GHF/gyroking/readme.txt

gyroking - firmware for the Gyro King 3lb battle bot
========
Xo Wang (http://www.geekshavefeelings.com)
Aaron Fan (http://aaronbot3000.blogspot.com)

About
-----
:D
