GHF/gyroking/3d_model/robot.sldasm

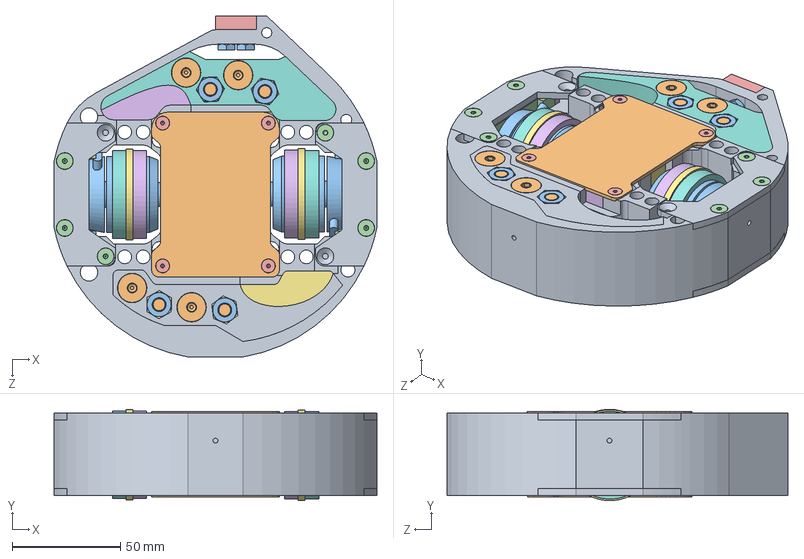
[picture p2: CAD file, 2013-03-10]
3d_model/robot.sldasm
149.2 x 42.2 x 157.7 mm
shell_xo
battery
motor x 2
motor_mount x 2
m3-8 x 8
hub x 2
tire_timing_belt x 2
hub_aluminum x 2
motor_lock x 4
cover x 2
6-32_nut x 4
damper-1_5-1_65 x 2
damper-2_70-1_5 x 2
damper-2-1_25 x 2
damper-0_375-1_25 x 2
damper-0_375-1 x 2
damper-0_34-1 x 2
damper-0_34-1_25 x 2
tooth
front_filler x 2
back_filler x 2
front_filler_wires
back_filler_wires
1-4_28_nut x 16
circuits
