GHF/gyroking/3d_model/motor_assm.sldasm

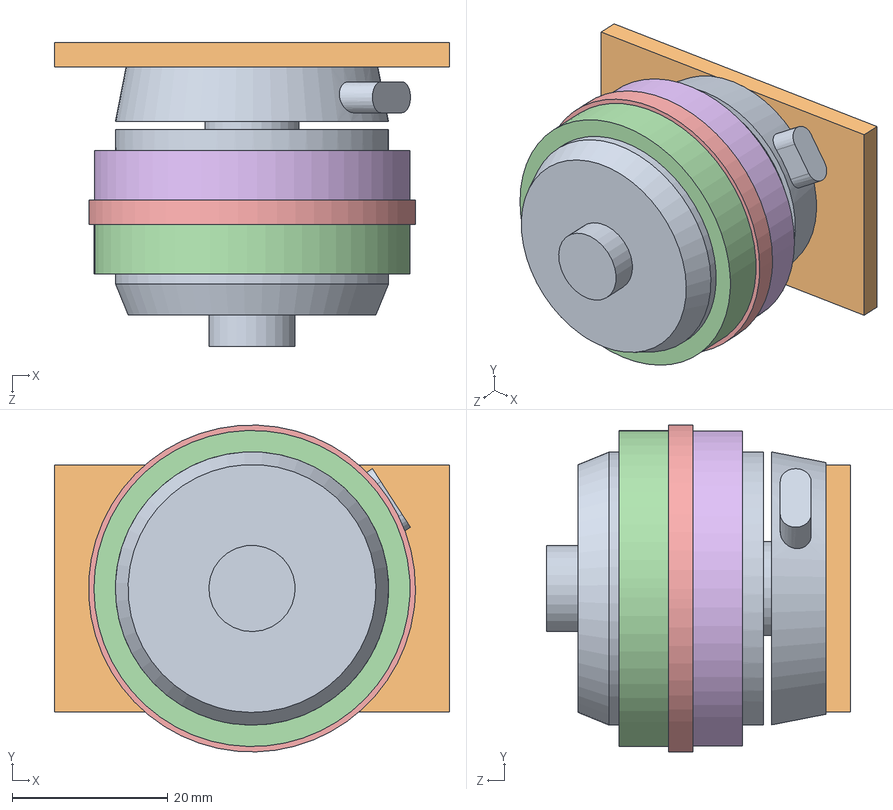
[picture p3: CAD file, 2013-03-10]
3d_model/motor_assm.sldasm
50.8 x 42.0 x 39.1 mm
motor
motor_mount
m3-8 x 4
hub
tire_timing_belt
hub_aluminum
