GHF/gyroking/3d_model/damper-2-1_25.sldprt

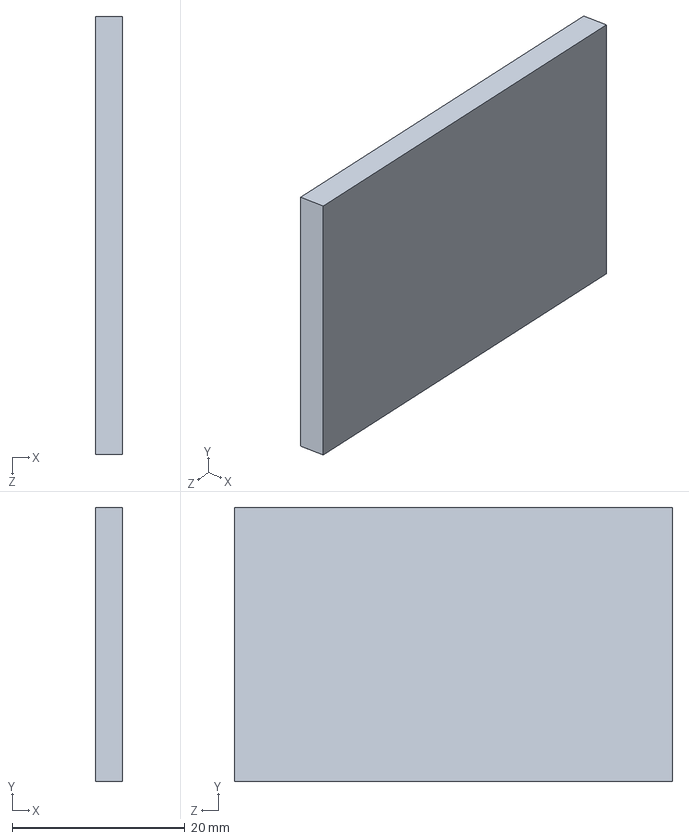
[picture p4: CAD file, 2013-03-10]
3d_model/damper-2-1_25.sldprt
3.17 x 31.8 x 50.8 mm
