GHF/gyroking/3d_model/damper-0_34-1_125.sldprt

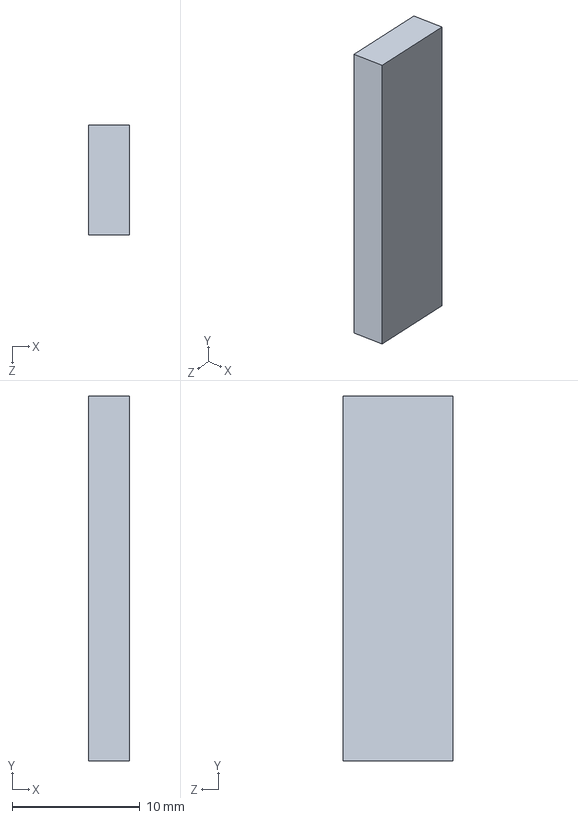
[picture p5: CAD file, 2013-03-10]
3d_model/damper-0_34-1_125.sldprt
3.17 x 28.6 x 8.64 mm
