GHF/gyroking/3d_model/damper-0_34-1.sldprt

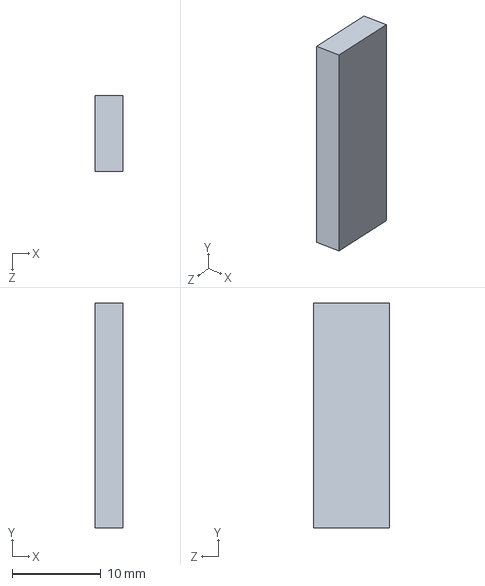
[picture p6: CAD file, 2013-03-10]
3d_model/damper-0_34-1.sldprt
3.17 x 25.4 x 8.64 mm
