GHF/gyroking/3d_model/damper-2_95-1_65.sldprt

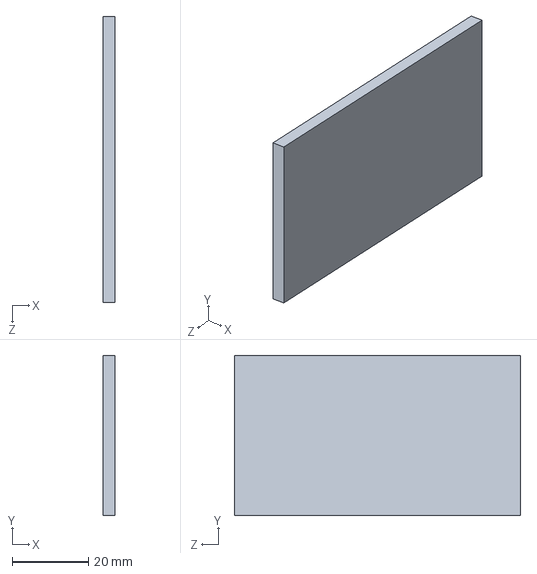
[picture p7: CAD file, 2013-03-10]
3d_model/damper-2_95-1_65.sldprt
3.17 x 41.9 x 74.9 mm
