GHF/gyroking/3d_model/cover.sldprt

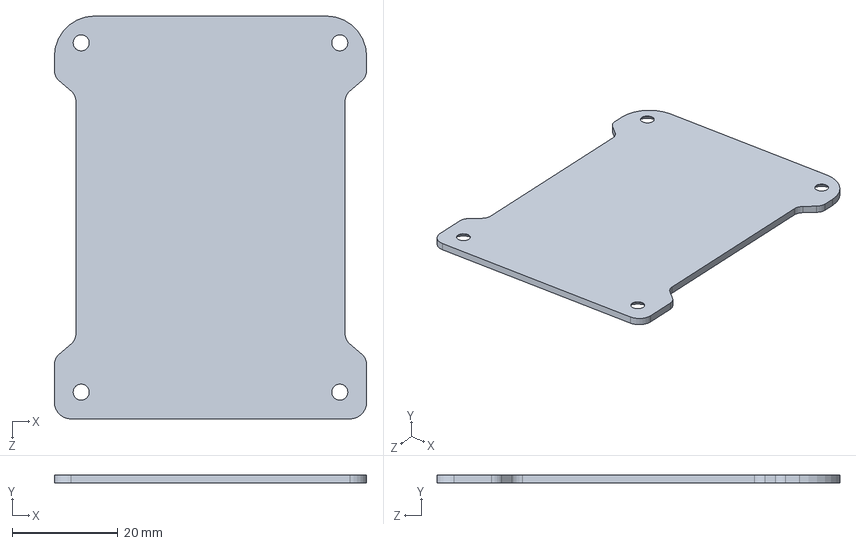
[picture p8: CAD file, 2013-03-10]
3d_model/cover.sldprt
59.1 x 1.59 x 76.2 mm
