GHF/gyroking/3d_model/back_filler_wires.sldprt

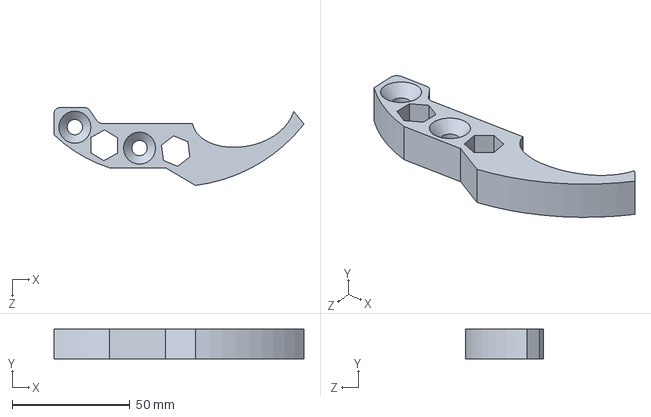
[picture p9: CAD file, 2013-03-10]
3d_model/back_filler_wires.sldprt
106.2 x 12.7 x 33.1 mm
