GHF/gyroking/3d_model/1_4-28_1_5.sldprt

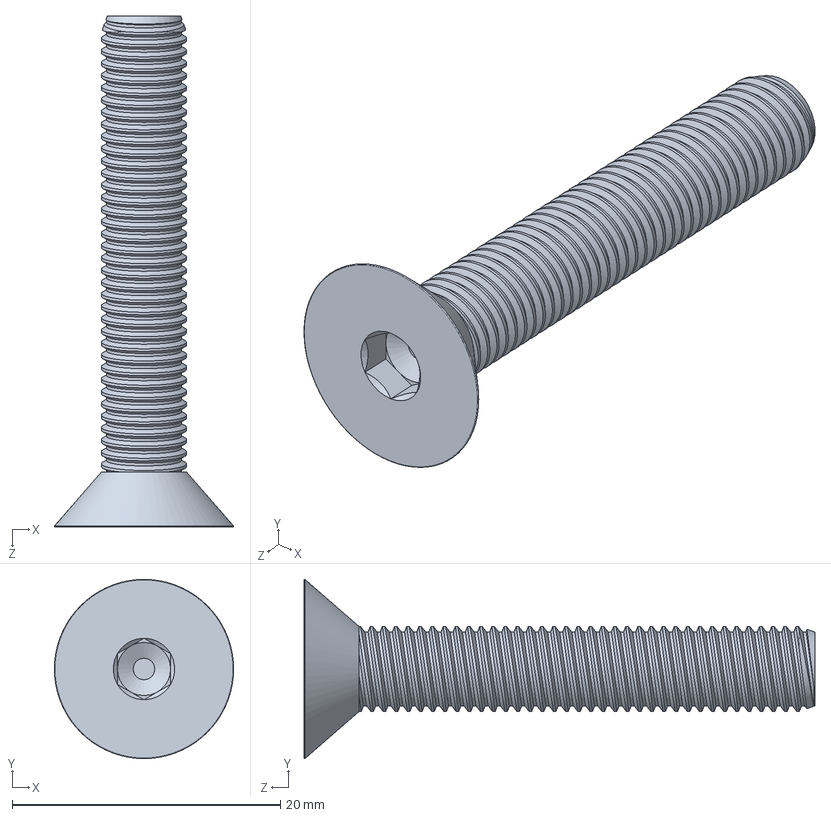
[picture p10: CAD file, 2013-03-10]
3d_model/1_4-28_1_5.sldprt
13.4 x 13.4 x 38.1 mm
