GHF/gyroking/3d_model/shell_waterjet.sldprt

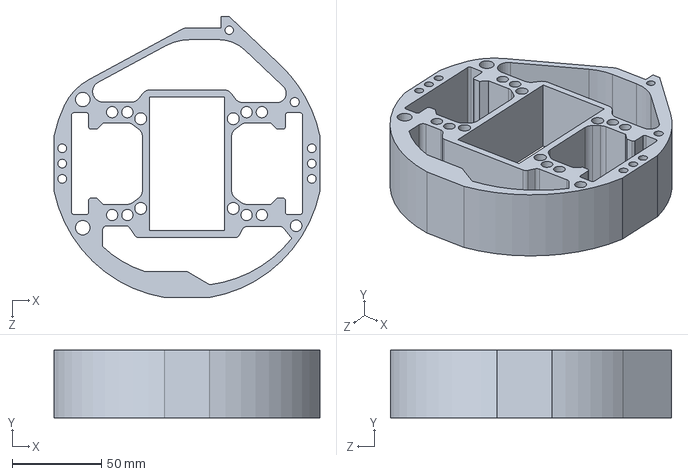
[picture p11: CAD file, 2013-03-10]
3d_model/shell_waterjet.sldprt
149.2 x 38.1 x 157.7 mm
