GHF/gyroking/3d_model/tire.sldprt

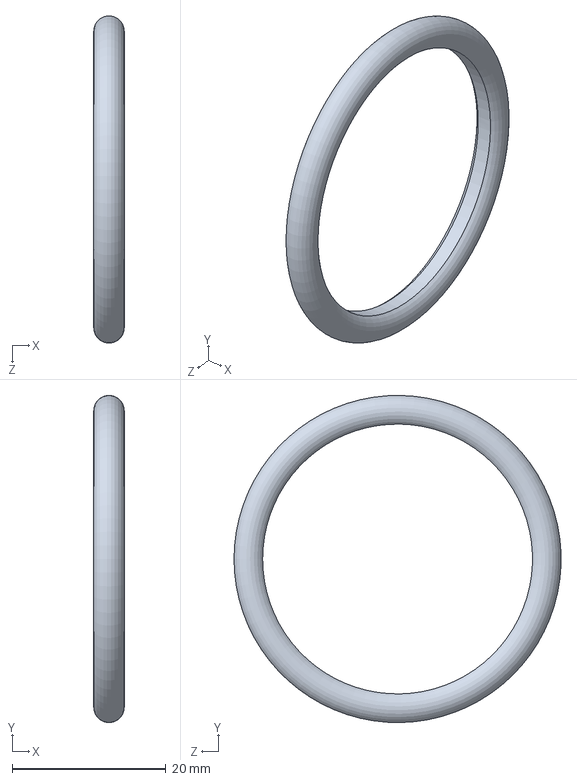
[picture p13: CAD file, 2013-03-10]
3d_model/tire.sldprt
3.99 x 42.6 x 42.6 mm
