GHF/gyroking/3d_model/damper-0_34-1_25.sldprt

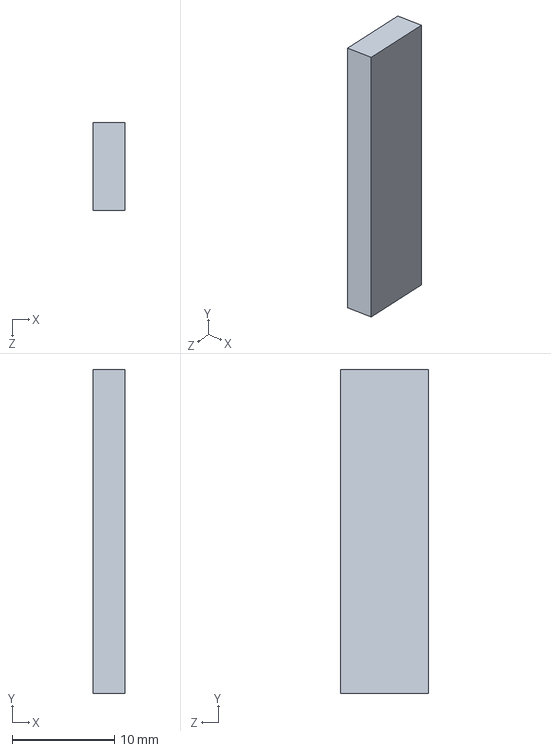
[picture p14: CAD file, 2013-03-10]
3d_model/damper-0_34-1_25.sldprt
3.17 x 31.8 x 8.64 mm
