GHF/gyroking/3d_model/tire_timing_belt.sldprt

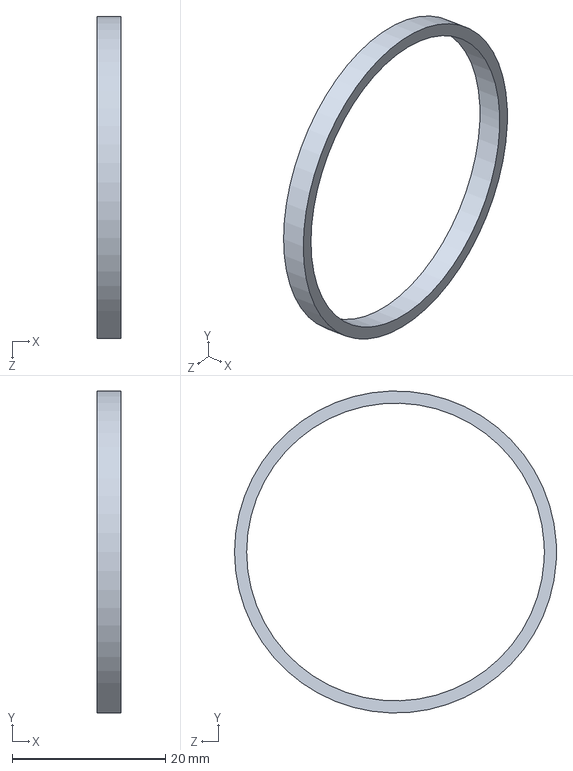
[picture p15: CAD file, 2013-03-10]
3d_model/tire_timing_belt.sldprt
3.17 x 42.0 x 42.0 mm
