GHF/gyroking/3d_model/circuits.sldprt

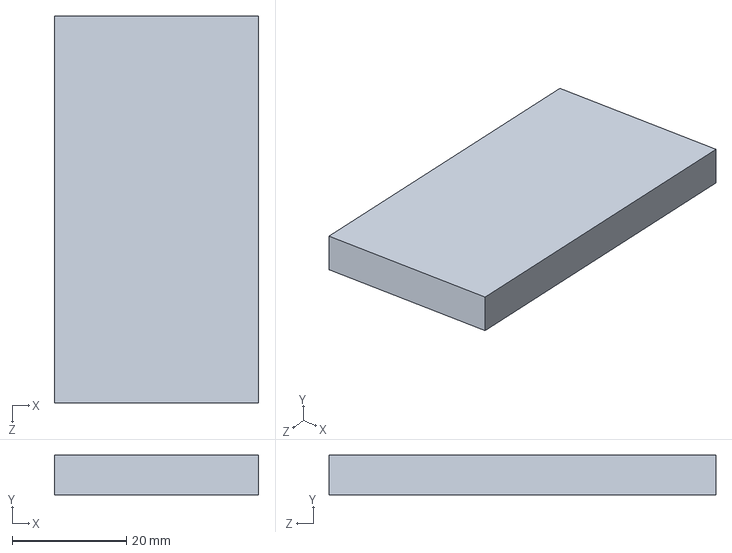
[picture p16: CAD file, 2013-03-10]
3d_model/circuits.sldprt
35.8 x 7.00 x 67.8 mm
