GHF/gyroking/3d_model/motor_mount.sldprt

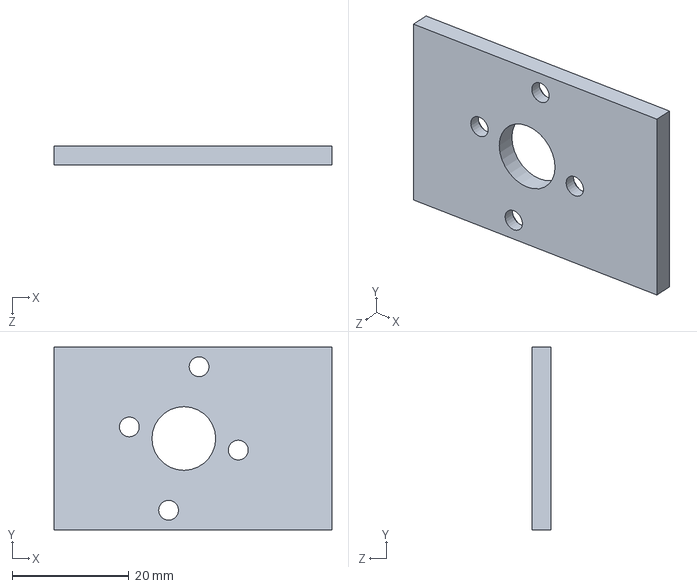
[picture p17: CAD file, 2013-03-10]
3d_model/motor_mount.sldprt
47.7 x 31.3 x 3.17 mm
