GHF/gyroking/3d_model/tooth.sldprt

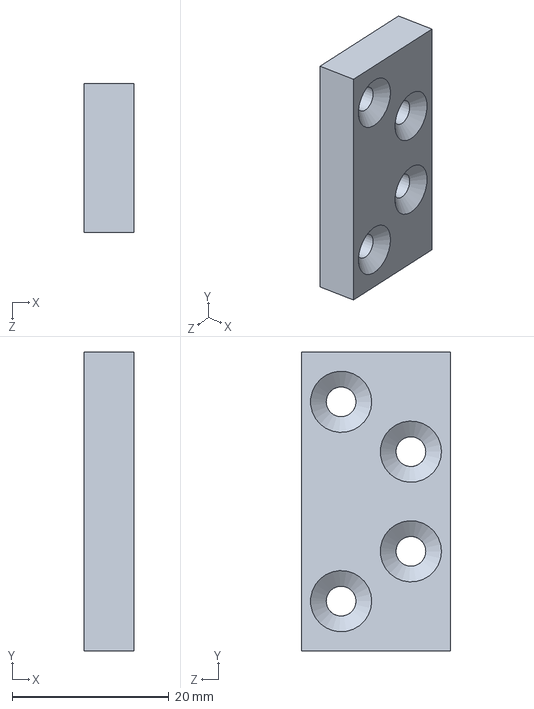
[picture p18: CAD file, 2013-03-10]
3d_model/tooth.sldprt
6.35 x 38.1 x 19.1 mm
