GHF/gyroking/3d_model/battery_350mah.sldprt

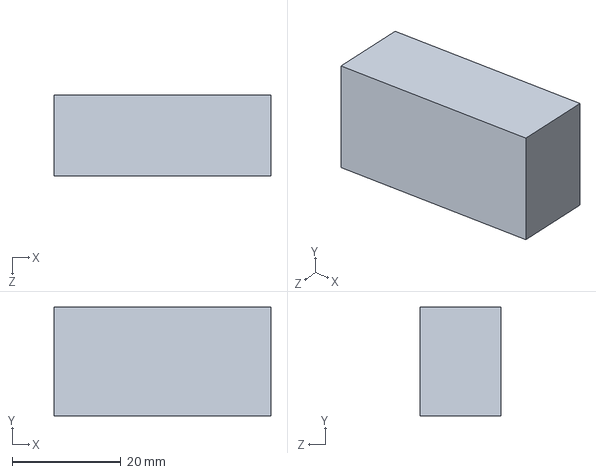
[picture p19: CAD file, 2013-03-10]
3d_model/battery_350mah.sldprt
40.0 x 20.0 x 15.0 mm
