GHF/gyroking/3d_model/4-40_3-8.sldprt

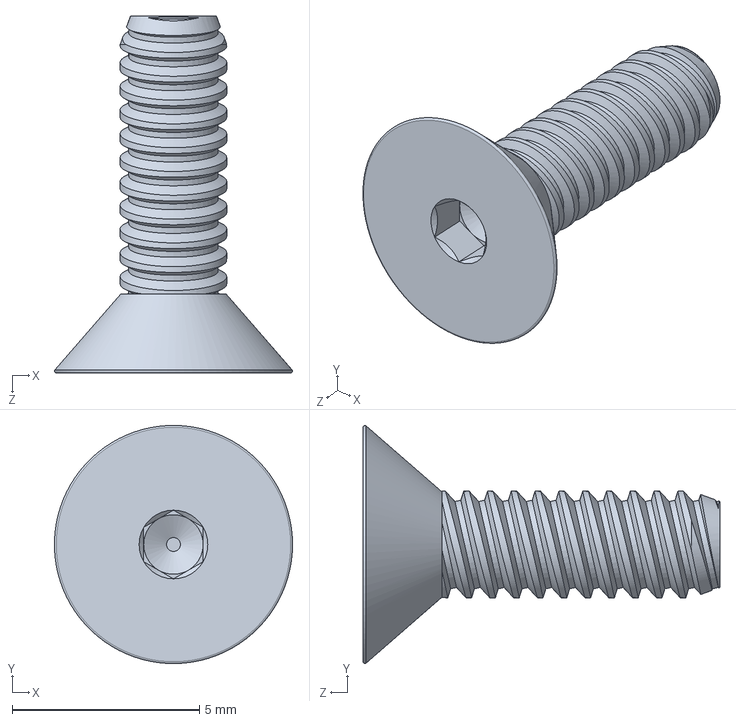
[picture p20: CAD file, 2013-03-10]
3d_model/4-40_3-8.sldprt
6.35 x 6.35 x 9.53 mm
