GHF/gyroking/3d_model/hub.sldprt

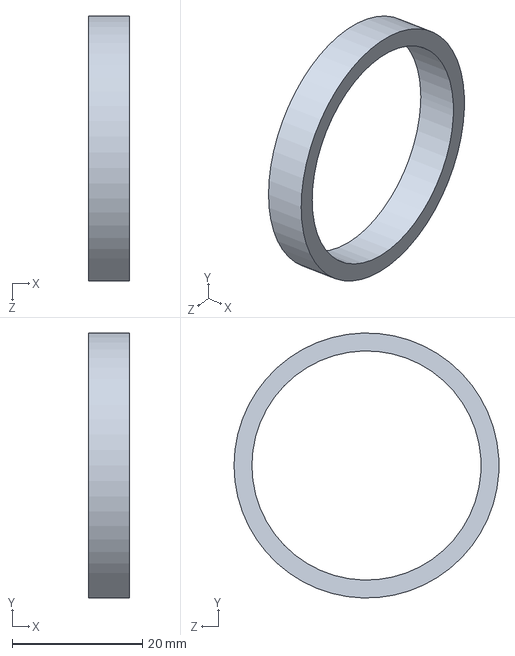
[picture p21: CAD file, 2013-03-10]
3d_model/hub.sldprt
6.35 x 40.6 x 40.7 mm
