GHF/gyroking/3d_model/battery_500mah.sldprt

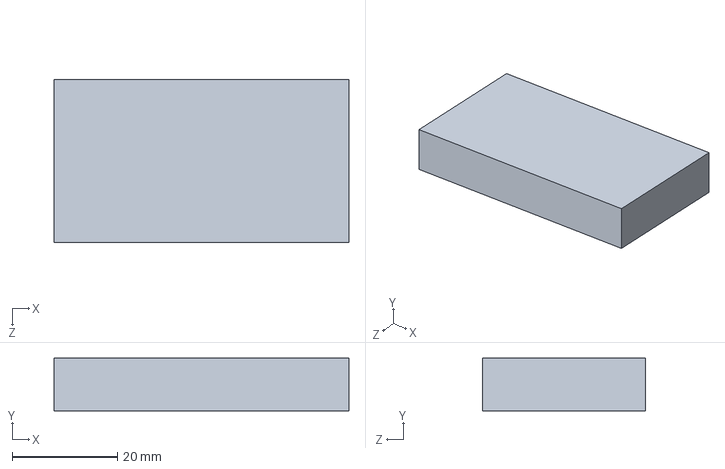
[picture p23: CAD file, 2013-03-10]
3d_model/battery_500mah.sldprt
56.0 x 10.0 x 31.0 mm
