GHF/gyroking/3d_model/battery.sldprt

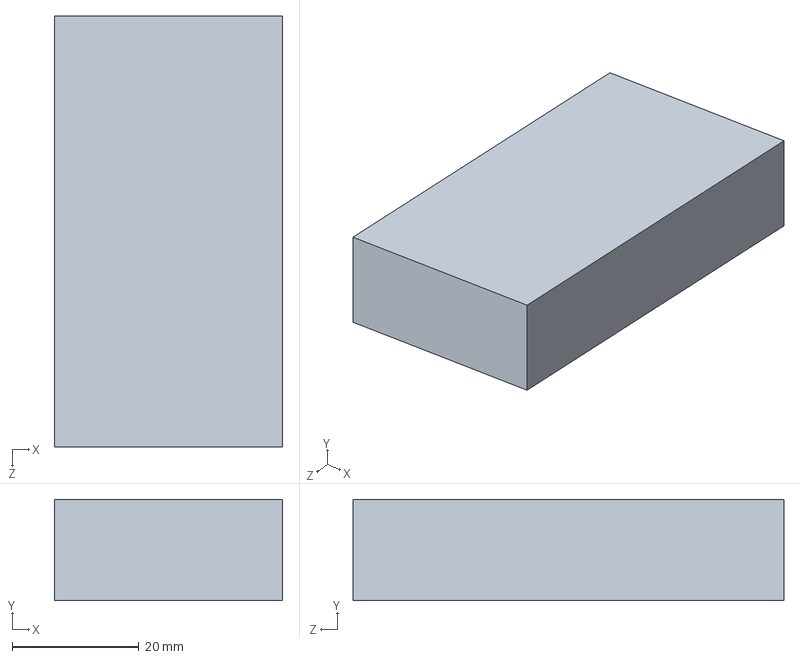
[picture p24: CAD file, 2013-03-10]
3d_model/battery.sldprt
36.0 x 16.0 x 68.0 mm
