GHF/gyroking/3d_model/4-40_1-2.sldprt

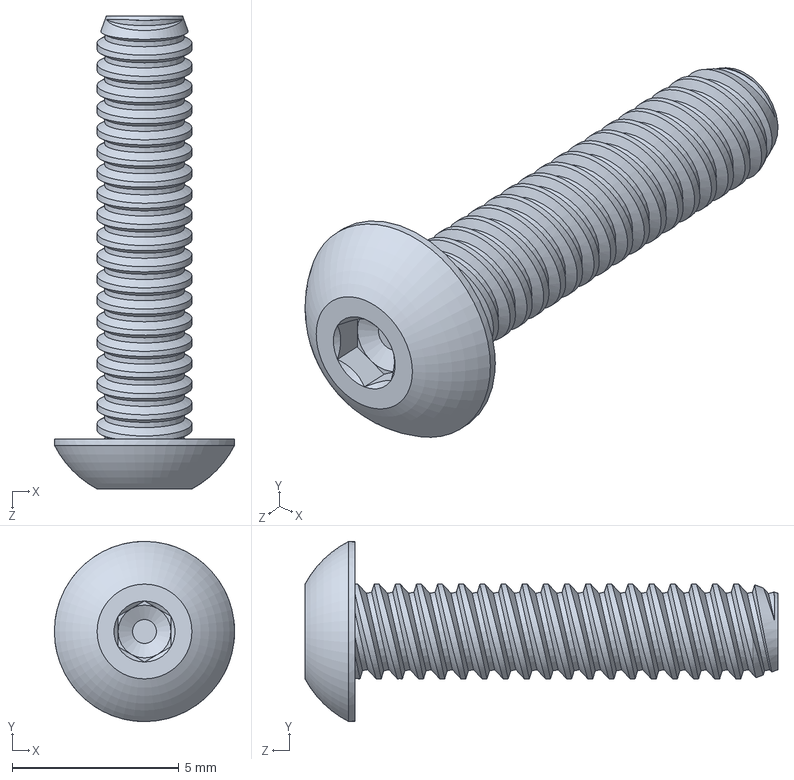
[picture p25: CAD file, 2013-03-10]
3d_model/4-40_1-2.sldprt
5.41 x 5.41 x 14.2 mm
