GHF/gyroking/3d_model/hub_aluminum.sldprt

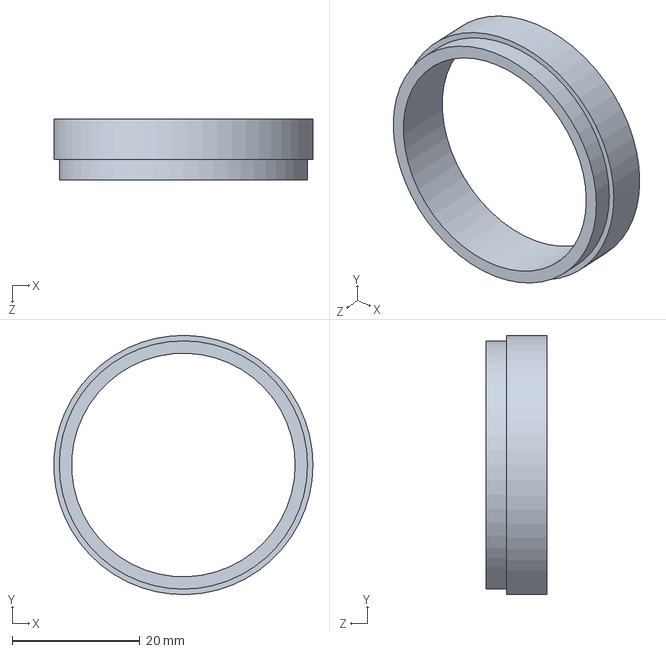
[picture p26: CAD file, 2013-03-10]
3d_model/hub_aluminum.sldprt
40.6 x 40.6 x 9.53 mm
