GHF/gyroking/3d_model/motor_lock.sldprt

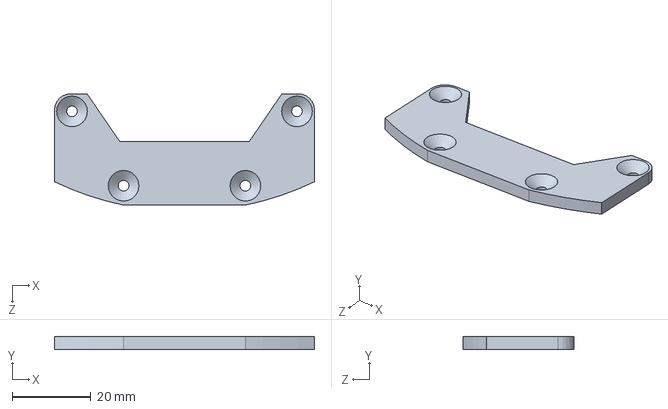
[picture p27: CAD file, 2013-03-10]
3d_model/motor_lock.sldprt
66.0 x 3.17 x 28.3 mm
