GHF/gyroking/3d_model/damper-2_70-1_5.sldprt

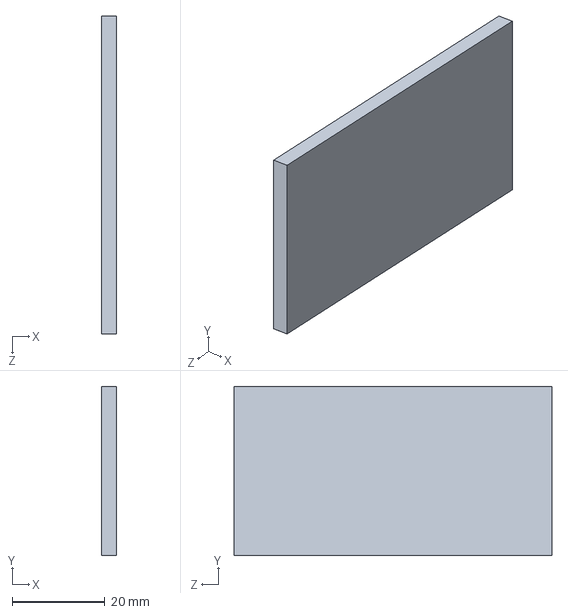
[picture p28: CAD file, 2013-03-10]
3d_model/damper-2_70-1_5.sldprt
3.17 x 36.5 x 68.6 mm
