GHF/gyroking/3d_model/front_filler.sldprt

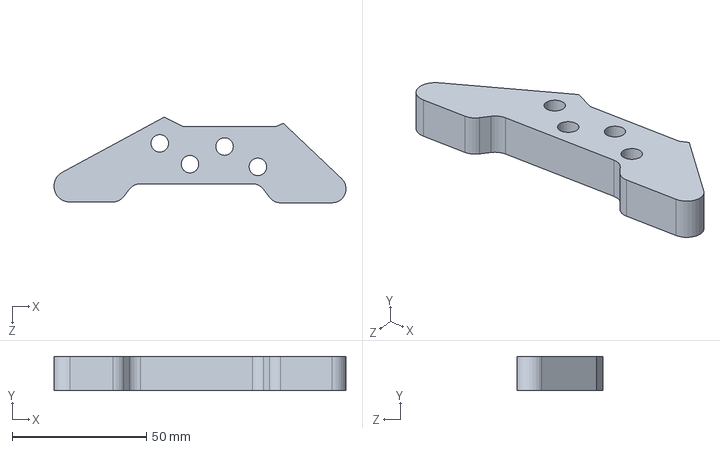
[picture p29: CAD file, 2013-03-10]
3d_model/front_filler.sldprt
108.6 x 12.7 x 31.9 mm
