GHF/gyroking/3d_model/damper-0_375-1_125.sldprt

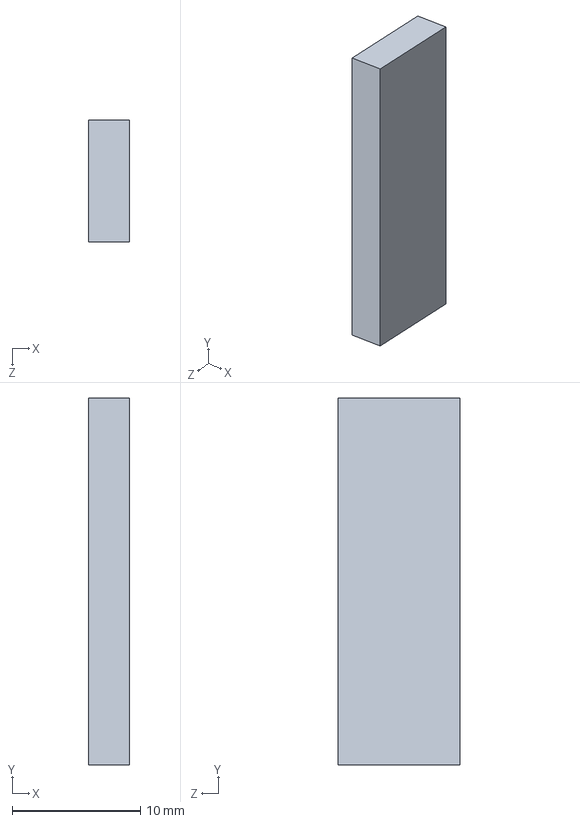
[picture p30: CAD file, 2013-03-10]
3d_model/damper-0_375-1_125.sldprt
3.17 x 28.6 x 9.53 mm
