GHF/gyroking/3d_model/motor.sldprt

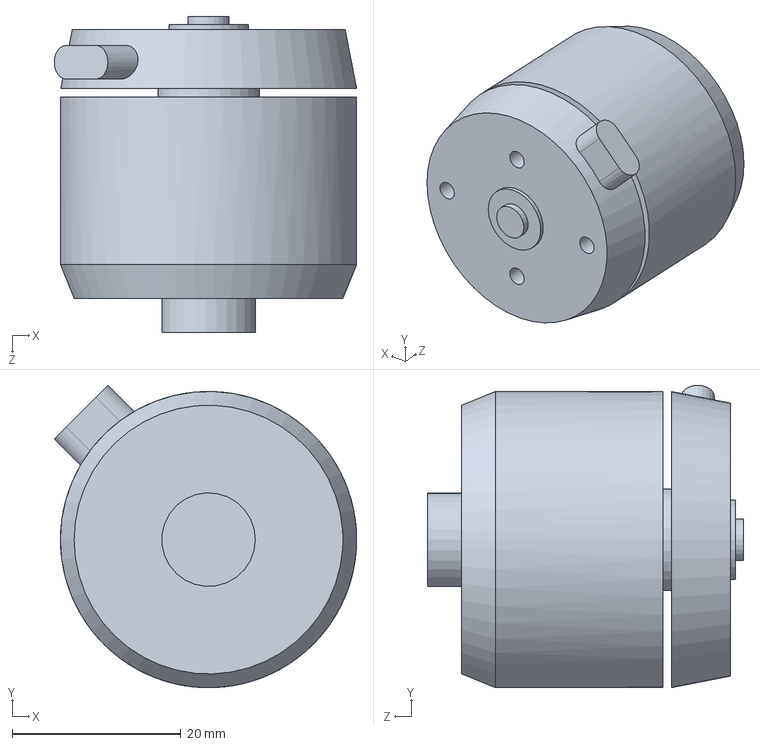
[picture p31: CAD file, 2013-03-10]
3d_model/motor.sldprt
35.9 x 35.9 x 37.5 mm
