GHF/gyroking/3d_model/back_filler.sldprt

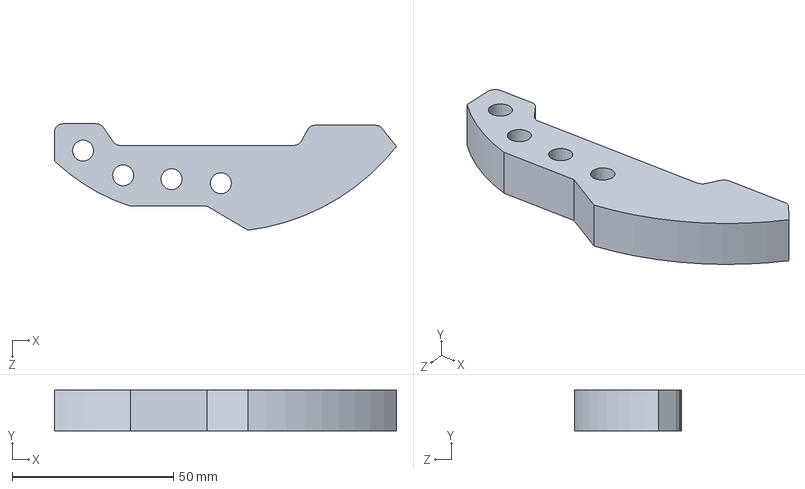
[picture p33: CAD file, 2013-03-10]
3d_model/back_filler.sldprt
106.2 x 12.7 x 33.1 mm
