GHF/gyroking/3d_model/damper-1_5-1_65.sldprt

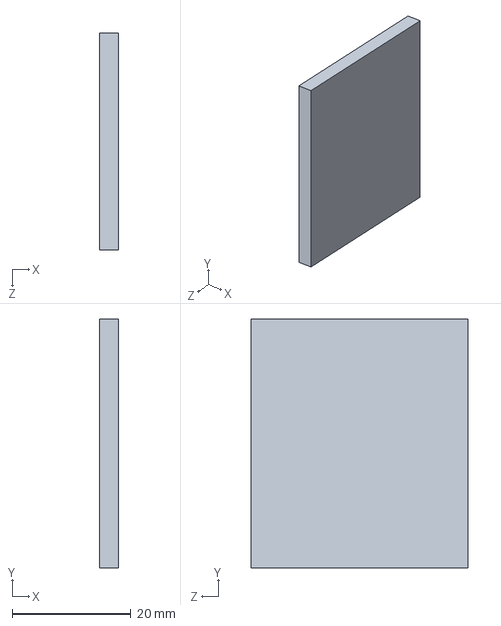
[picture p34: CAD file, 2013-03-10]
3d_model/damper-1_5-1_65.sldprt
3.17 x 41.9 x 36.5 mm
