GHF/gyroking/3d_model/damper-0_375-1_25.sldprt

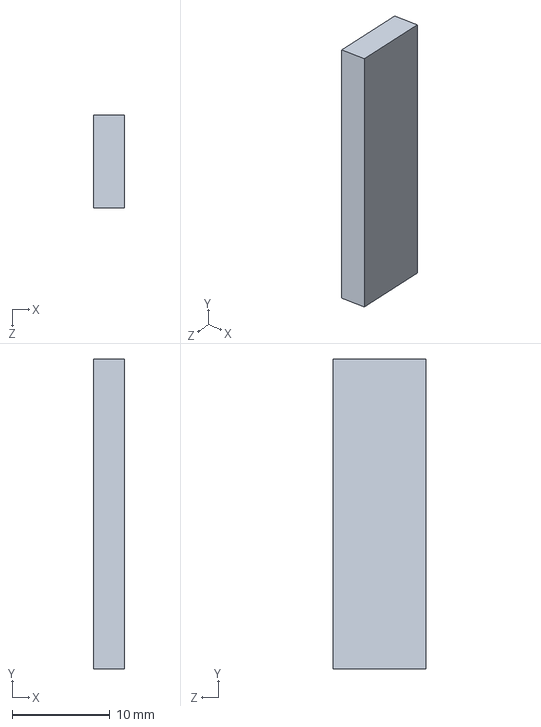
[picture p35: CAD file, 2013-03-10]
3d_model/damper-0_375-1_25.sldprt
3.17 x 31.8 x 9.53 mm
