GHF/gyroking/3d_model/6-32_3-8.sldprt

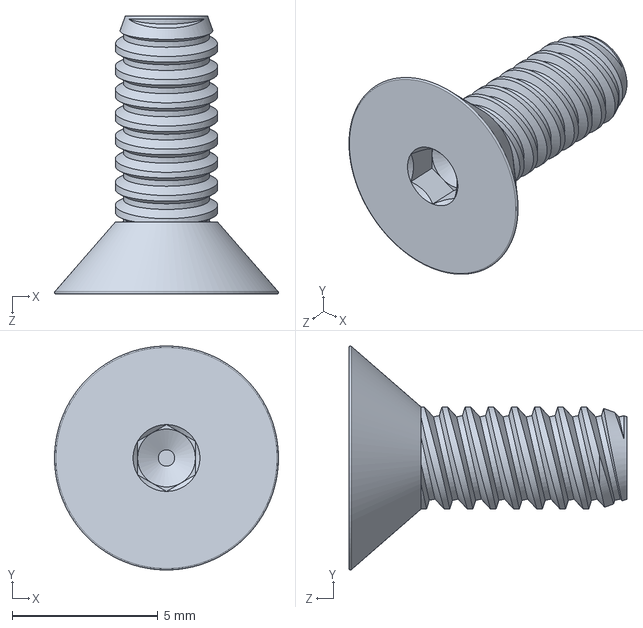
[picture p36: CAD file, 2013-03-10]
3d_model/6-32_3-8.sldprt
7.68 x 7.67 x 9.53 mm
