GHF/gyroking/3d_model/shell.sldprt

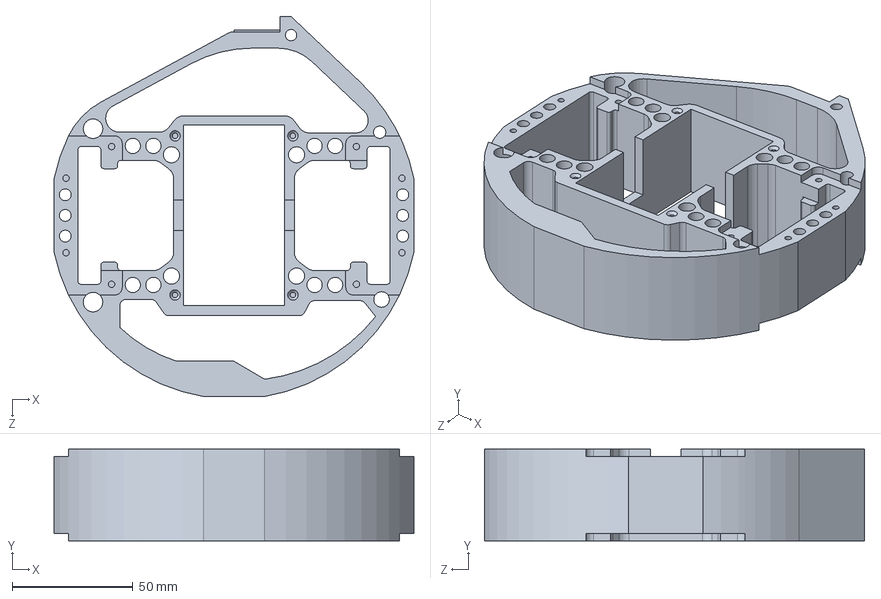
[picture p38: CAD file, 2013-03-10]
3d_model/shell.sldprt
149.2 x 38.1 x 157.7 mm
