GHF/gyroking/3d_model/heatsink.SLDPRT

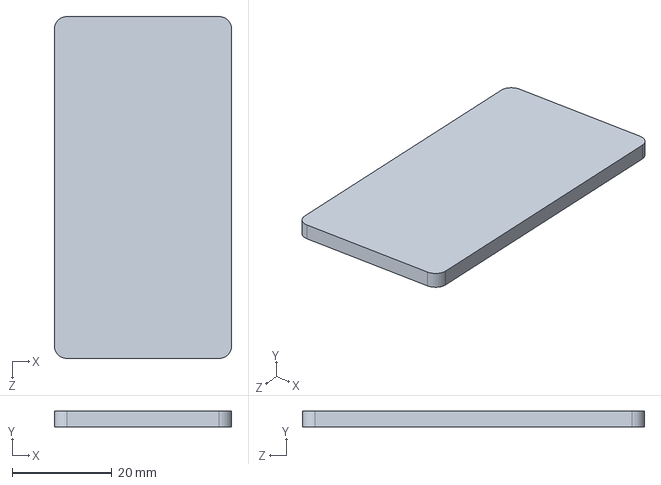
[picture p39: CAD file, 2013-03-10]
3d_model/heatsink.SLDPRT
35.6 x 3.17 x 68.6 mm
