GHF/gyroking/(list of files, cad)

Other CAD files:
ChibiOS/demos/STM8L-STM8L152-DISCOVERY-STVD/cosmic/cosmic.stp
ChibiOS/demos/STM8L-STM8L152-DISCOVERY-STVD/raisonance/raisonance.stp
ChibiOS/demos/STM8S-STM8S105-DISCOVERY-STVD/cosmic/cosmic.stp
ChibiOS/demos/STM8S-STM8S105-DISCOVERY-STVD/raisonance/raisonance.stp
ChibiOS/testhal/STM8S/SPI/cosmic/cosmic.stp
ChibiOS/testhal/STM8S/SPI/raisonance/raisonance.stp
3d_model/1_4-20_1_5.sldprt
3d_model/1-4_28_boltnut.sldasm
3d_model/1-4_28_nut.SLDPRT
3d_model/6-32_nut.sldprt
3d_model/m3-8.sldprt
