GHF/gyroking/hardware/Tortilla.brd

## EAGLE design hardware/Tortilla.brd (2012-12-03)

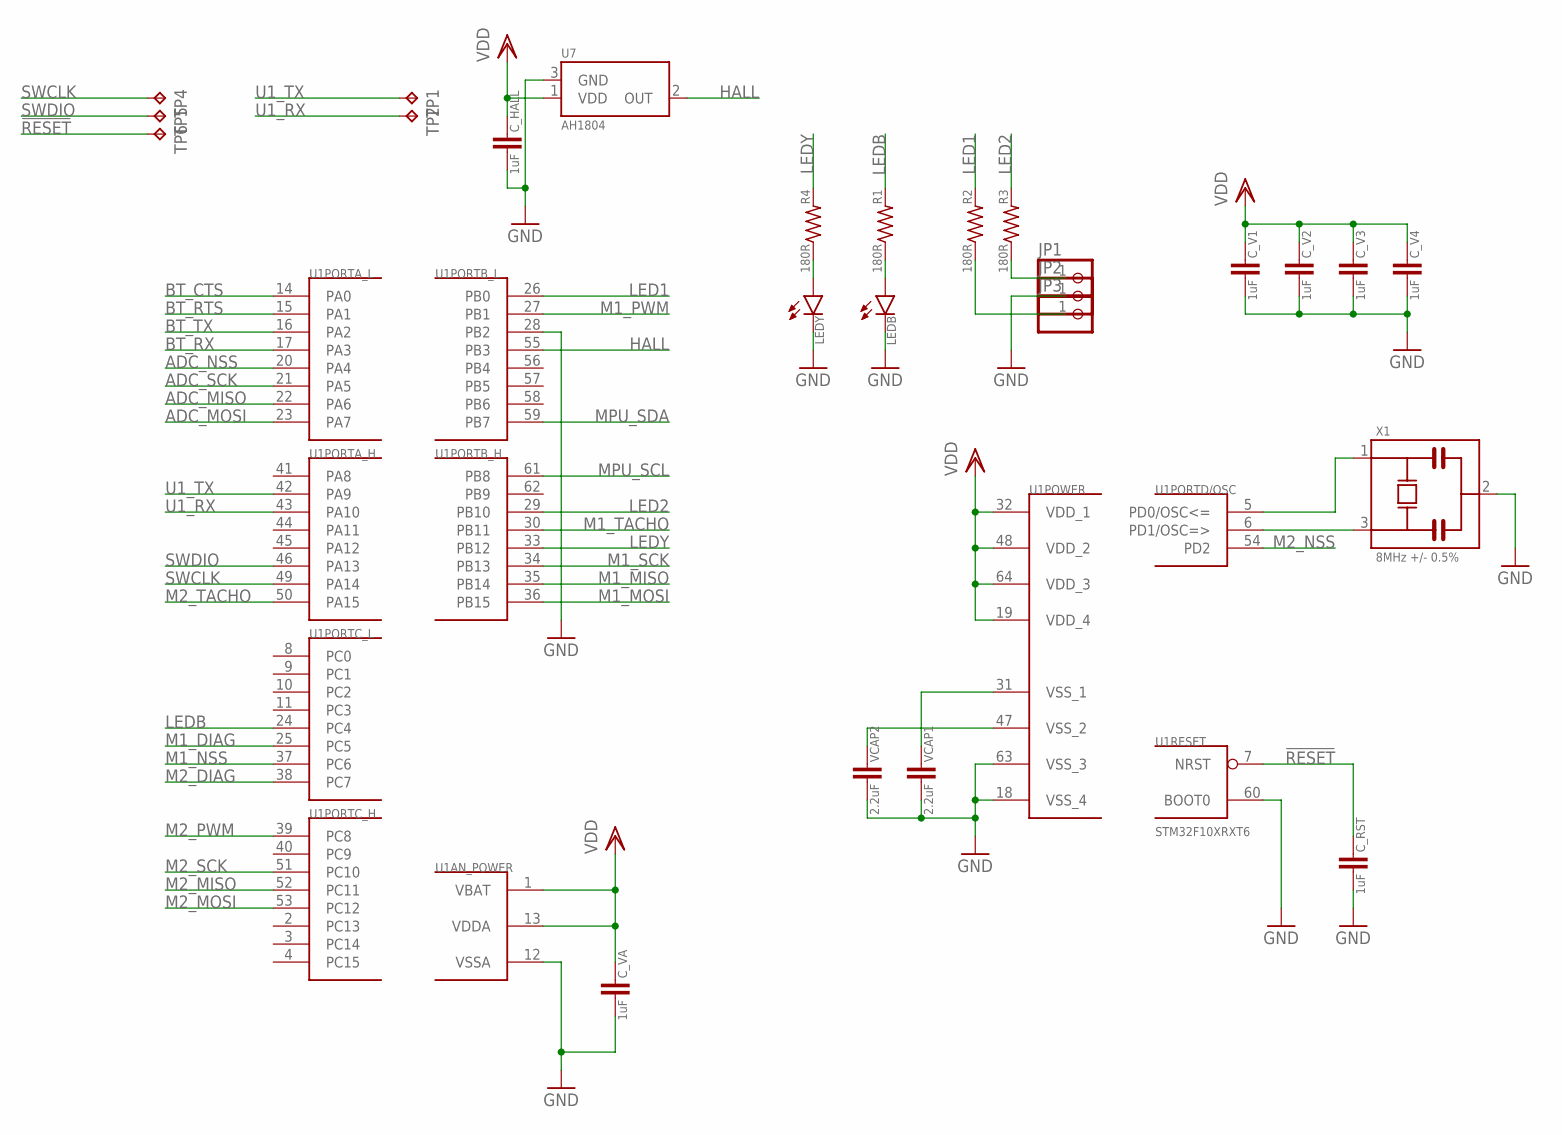
[picture p40: schematic Tortilla.sch, sheet 1]

Parts:
C_HALL: 1uF; 0603
C_RST: 1uF; 0603
C_V1, C_V2, C_V3, C_V4: 1uF; 0603
C_VA: 1uF; 0603
JP1, JP2, JP3: PINHD-1X1; 1X01
LEDB: LED0805; 0805_POL
LEDY: LED0805; 0805_POL
R1, R2, R3, R4: 180R; 0603
TP1, TP2, TP4, TP5, TP6: TPB1,27; B1,27
U1: STM32F10XRXT6; TQFP64
U7: AH1804; SOT23-3
VCAP1, VCAP2: 2.2uF; 0603
X1: 8MHz +/- 0.5%; MURATA_CSTCE

Connections:
!RESET: C_RST.1, TP6.TP, U1.7 (NRST)
ADC_MISO: U1.22 (PA6); also elsewhere on the board
ADC_MOSI: U1.23 (PA7); also elsewhere on the board
ADC_NSS: U1.20 (PA4); also elsewhere on the board
ADC_SCK: U1.21 (PA5); also elsewhere on the board
BT_CTS: U1.14 (PA0); also elsewhere on the board
BT_RTS: U1.15 (PA1); also elsewhere on the board
BT_RX: U1.17 (PA3); also elsewhere on the board
BT_TX: U1.16 (PA2); also elsewhere on the board
GND: C_HALL.2, C_RST.2, C_V1.2, C_V2.2, C_V3.2, C_V4.2, C_VA.2, JP2.1, LEDB.- (C), LEDY.- (C), U1.12 (VSSA), U1.18 (VSS_4), U1.28 (PB2), U1.60 (BOOT0), U1.63 (VSS_3), U7.3 (GND), VCAP1.2, VCAP2.2, X1.2; also elsewhere on the board
HALL: U1.55 (PB3), U7.2 (OUT)
LED1: R2.2, U1.26 (PB0)
LED2: R3.2, U1.29 (PB10)
LEDB: R1.2, U1.24 (PC4)
LEDY: R4.2, U1.33 (PB12)
M1_DIAG: U1.25 (PC5); also elsewhere on the board
M1_MISO: U1.35 (PB14); also elsewhere on the board
M1_MOSI: U1.36 (PB15); also elsewhere on the board
M1_NSS: U1.37 (PC6); also elsewhere on the board
M1_PWM: U1.27 (PB1); also elsewhere on the board
M1_SCK: U1.34 (PB13); also elsewhere on the board
M1_TACHO: U1.30 (PB11); also elsewhere on the board
M2_DIAG: U1.38 (PC7); also elsewhere on the board
M2_MISO: U1.52 (PC11); also elsewhere on the board
M2_MOSI: U1.53 (PC12); also elsewhere on the board
M2_NSS: U1.54 (PD2); also elsewhere on the board
M2_PWM: U1.39 (PC8); also elsewhere on the board
M2_SCK: U1.51 (PC10); also elsewhere on the board
M2_TACHO: U1.50 (PA15); also elsewhere on the board
MPU_SCL: U1.61 (PB8); also elsewhere on the board
MPU_SDA: U1.59 (PB7); also elsewhere on the board
unnamed: U1.6 (PD1/OSC=>), X1.3
unnamed: U1.5 (PD0/OSC<=), X1.1
unnamed: U1.47 (VSS_2), VCAP2.1
unnamed: U1.31 (VSS_1), VCAP1.1
unnamed: LEDB.+ (A), R1.1
unnamed: JP1.1, R3.1
unnamed: JP3.1, R2.1
unnamed: LEDY.+ (A), R4.1
SWCLK: TP4.TP, U1.49 (PA14)
SWDIO: TP5.TP, U1.46 (PA13)
U1_RX: TP2.TP, U1.43 (PA10)
U1_TX: TP1.TP, U1.42 (PA9)
VDD: C_HALL.1, C_V1.1, C_V2.1, C_V3.1, C_V4.1, C_VA.1, U1.1 (VBAT), U1.13 (VDDA), U1.19 (VDD_4), U1.32 (VDD_1), U1.48 (VDD_2), U1.64 (VDD_3), U7.1 (VDD); also elsewhere on the board

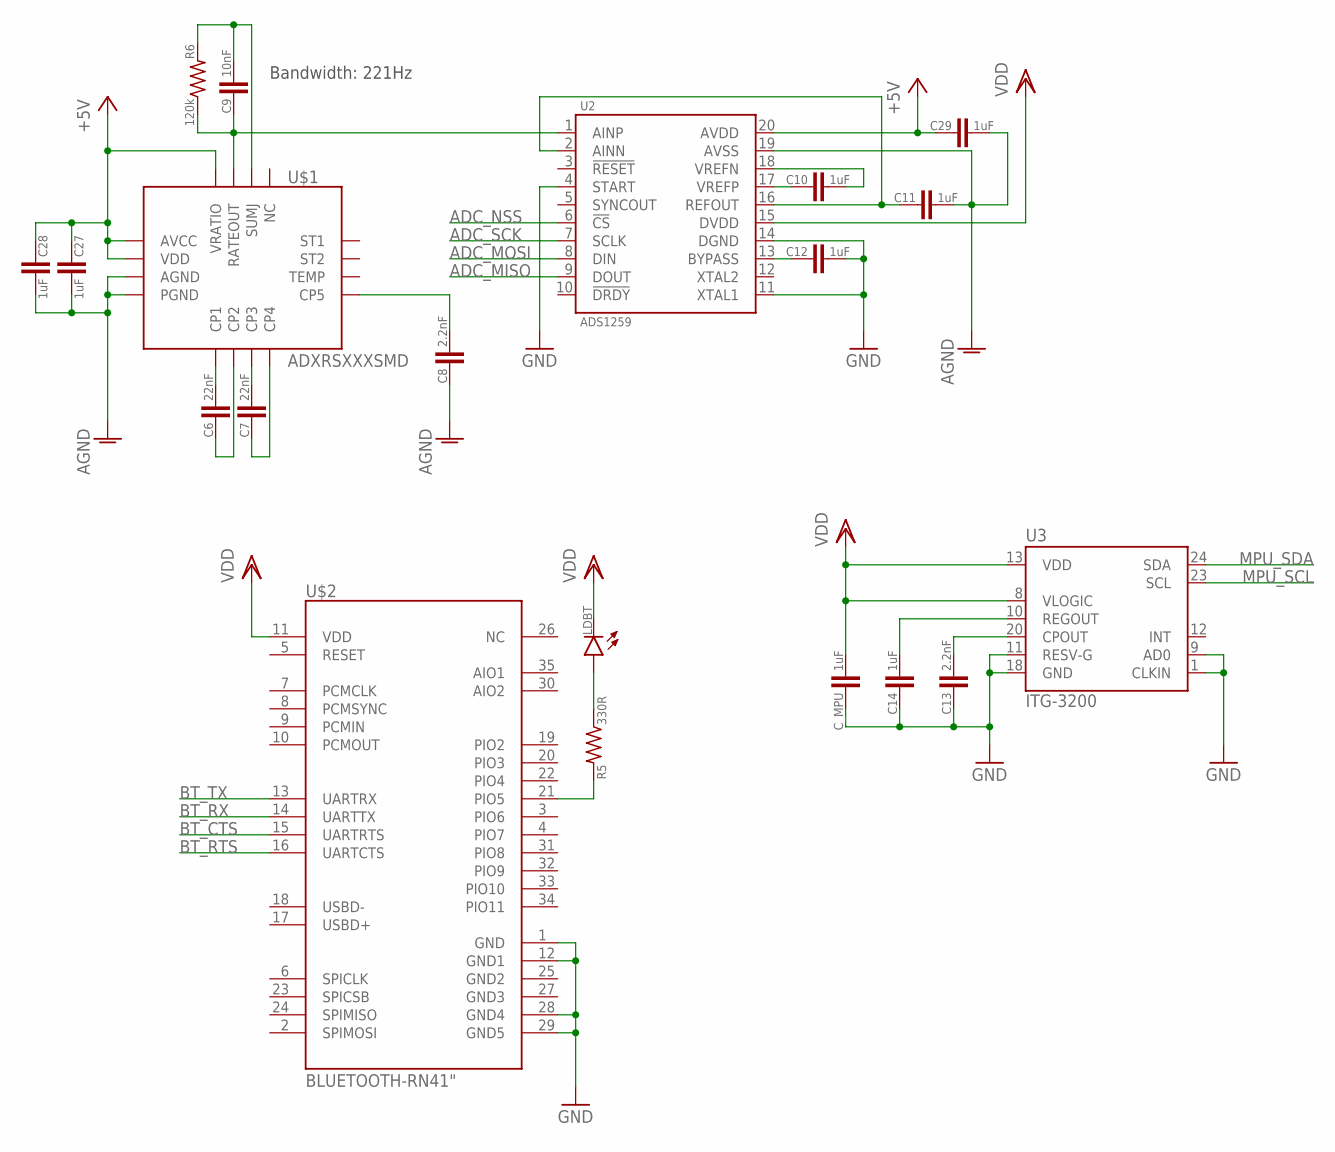
[picture p41: schematic Tortilla.sch, sheet 2]

Parts:
C6, C7: 22nF; 0603
C8, C13: 2.2nF; 0603
C9: 10nF; 0603
C10, C11, C12, C14, C27, C28, C29: 1uF; 0603
C_MPU: 1uF; 0603
LDBT: LED0805; 0805_POL
R5: 330R; 0603
R6: 120k; 0603
U2: ADS1259; TSSOP-20
U3: ITG-3200; QFN-24
U$1: ADXRSXXXSMD; BC-32
U$2: BLUETOOTH-RN41"; RN41

Connections:
+5V: C27.1, C28.1, C29.1, U2.20 (AVDD), U$1.AVCC, U$1.VDD, U$1.VRATIO; also elsewhere on the board
ADC_MISO: U2.9 (DOUT); also elsewhere on the board
ADC_MOSI: U2.8 (DIN); also elsewhere on the board
ADC_NSS: U2.6 (!CS); also elsewhere on the board
ADC_SCK: U2.7 (SCLK); also elsewhere on the board
AGND: C8.1, C11.2, C27.2, C28.2, C29.2, U2.19 (AVSS), U$1.AGND, U$1.PGND; also elsewhere on the board
BT_CTS: U$2.15 (UARTRTS); also elsewhere on the board
BT_RTS: U$2.16 (UARTCTS); also elsewhere on the board
BT_RX: U$2.14 (UARTTX); also elsewhere on the board
BT_TX: U$2.13 (UARTRX); also elsewhere on the board
GND: C12.2, C13.1, C14.1, C_MPU.1, U2.4 (START), U2.11 (XTAL1), U2.14 (DGND), U3.1 (CLKIN), U3.9 (AD0), U3.11 (RESV-G), U3.18 (GND), U$2.1 (GND), U$2.12 (GND1), U$2.28 (GND4), U$2.29 (GND5); also elsewhere on the board
MPU_SCL: U3.23 (SCL); also elsewhere on the board
MPU_SDA: U3.24 (SDA); also elsewhere on the board
unnamed: C6.2, U$1.CP1
unnamed: C6.1, U$1.CP2
unnamed: C7.2, U$1.CP3
unnamed: C7.1, U$1.CP4
unnamed: C8.2, U$1.CP5
unnamed: C9.1, R6.1, U2.1 (AINP), U$1.RATEOUT
unnamed: C9.2, R6.2, U$1.SUMJ
unnamed: C11.1, U2.2 (AINN), U2.16 (REFOUT)
unnamed: C10.2, U2.18 (VREFN)
unnamed: C10.1, U2.17 (VREFP)
unnamed: C12.1, U2.13 (BYPASS)
unnamed: C13.2, U3.20 (CPOUT)
unnamed: C14.2, U3.10 (REGOUT)
unnamed: R5.2, U$2.21 (PIO5)
unnamed: LDBT.+ (A), R5.1
VDD: C_MPU.2, LDBT.- (C), U2.15 (DVDD), U3.8 (VLOGIC), U3.13 (VDD), U$2.11 (VDD); also elsewhere on the board

Notes on the sheet:
Bandwidth: 221Hz

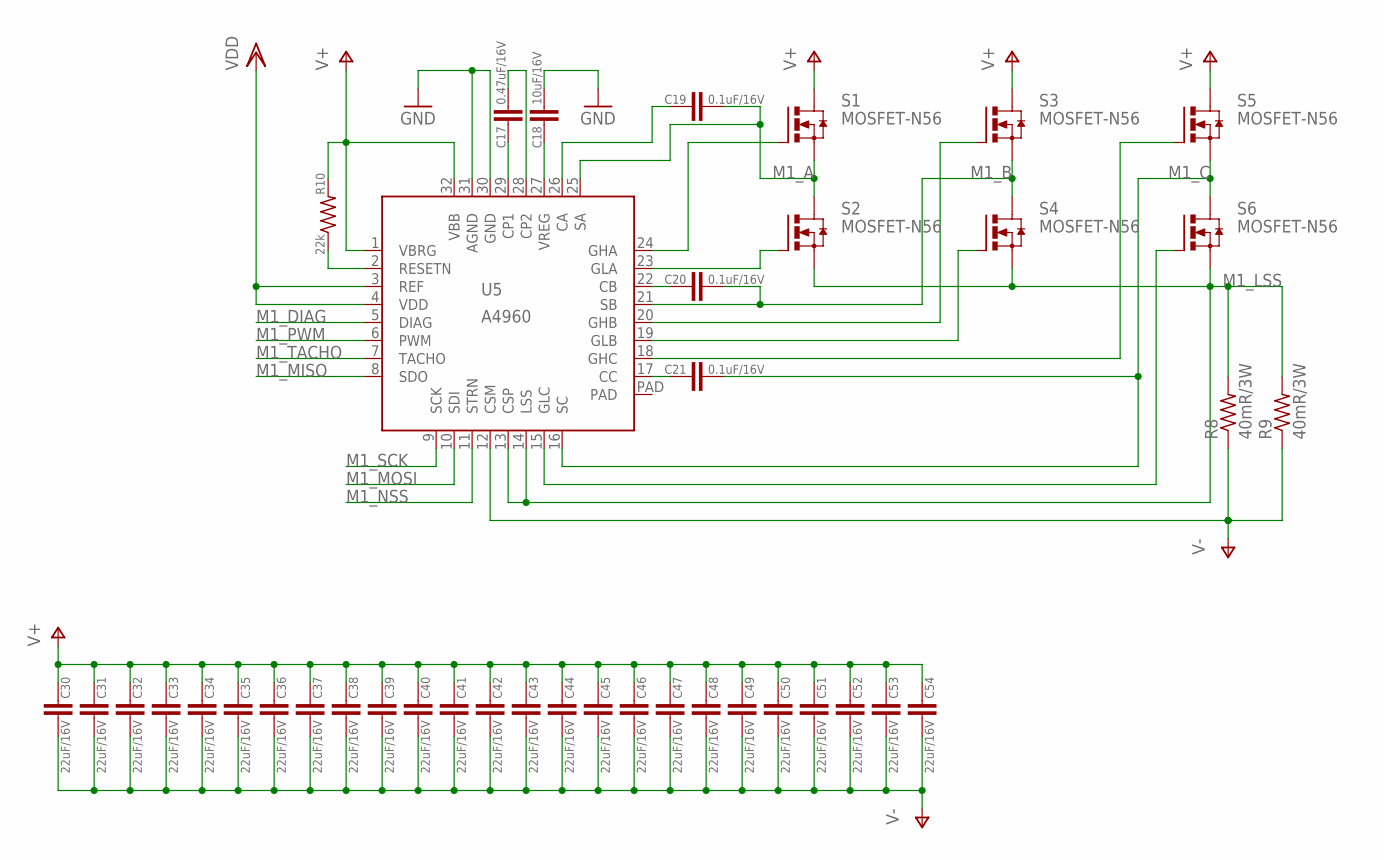
[picture p42: schematic Tortilla.sch, sheet 3]

Parts:
C17: 0.47uF/16V; 0603
C18: 10uF/16V; 0805
C19, C20, C21: 0.1uF/16V; 0603
C30, C31, C32, C33, C34, C35, C36, C37, C38, C39, C40, C41, C42, C43, C44, C45, C46, C47, C48, C49, C50, C51, C52, C53, C54: 22uF/16V; 1206
R8, R9: 40mR/3W; R2512
R10: 22k; 0603
S1, S2, S3, S4, S5, S6: MOSFET-N56; SON-5X6
U5: A4960; LQFP32-THERMPAD

Connections:
GND: C18.2, U5.30 (GND), U5.31 (AGND); also elsewhere on the board
M1_A: C19.2, S1.S1 (S), S1.S2 (S), S1.S3 (S), S2.D, U5.25 (SA)
M1_B: C20.2, S3.S1 (S), S3.S2 (S), S3.S3 (S), S4.D, U5.21 (SB)
M1_C: C21.2, S5.S1 (S), S5.S2 (S), S5.S3 (S), S6.D, U5.16 (SC)
M1_DIAG: U5.5 (DIAG); also elsewhere on the board
M1_LSS: R8.2, R9.2, S2.S1 (S), S2.S2 (S), S2.S3 (S), S4.S1 (S), S4.S2 (S), S4.S3 (S), S6.S1 (S), S6.S2 (S), S6.S3 (S), U5.13 (CSP), U5.14 (LSS)
M1_MISO: U5.8 (SDO); also elsewhere on the board
M1_MOSI: U5.10 (SDI); also elsewhere on the board
M1_NSS: U5.11 (STRN); also elsewhere on the board
M1_PWM: U5.6 (PWM); also elsewhere on the board
M1_SCK: U5.9 (SCK); also elsewhere on the board
M1_TACHO: U5.7 (TACHO); also elsewhere on the board
unnamed: C17.1, U5.29 (CP1)
unnamed: C17.2, U5.28 (CP2)
unnamed: C18.1, U5.27 (VREG)
unnamed: S1.G, U5.24 (GHA)
unnamed: S2.G, U5.23 (GLA)
unnamed: C19.1, U5.26 (CA)
unnamed: S3.G, U5.20 (GHB)
unnamed: S4.G, U5.19 (GLB)
unnamed: C20.1, U5.22 (CB)
unnamed: S5.G, U5.18 (GHC)
unnamed: S6.G, U5.15 (GLC)
unnamed: C21.1, U5.17 (CC)
unnamed: R10.1, U5.2 (RESETN)
V+: C30.1, C31.1, C32.1, C33.1, C34.1, C35.1, C36.1, C37.1, C38.1, C39.1, C40.1, C41.1, C42.1, C43.1, C44.1, C45.1, C46.1, C47.1, C48.1, C49.1, C50.1, C51.1, C52.1, C53.1, C54.1, R10.2, S1.D, S3.D, S5.D, U5.1 (VBRG), U5.32 (VBB); also elsewhere on the board
V-: C30.2, C31.2, C32.2, C33.2, C34.2, C35.2, C36.2, C37.2, C38.2, C39.2, C40.2, C41.2, C42.2, C43.2, C44.2, C45.2, C46.2, C47.2, C48.2, C49.2, C50.2, C51.2, C52.2, C53.2, C54.2, R8.1, R9.1, U5.12 (CSM); also elsewhere on the board
VDD: U5.3 (REF), U5.4 (VDD); also elsewhere on the board

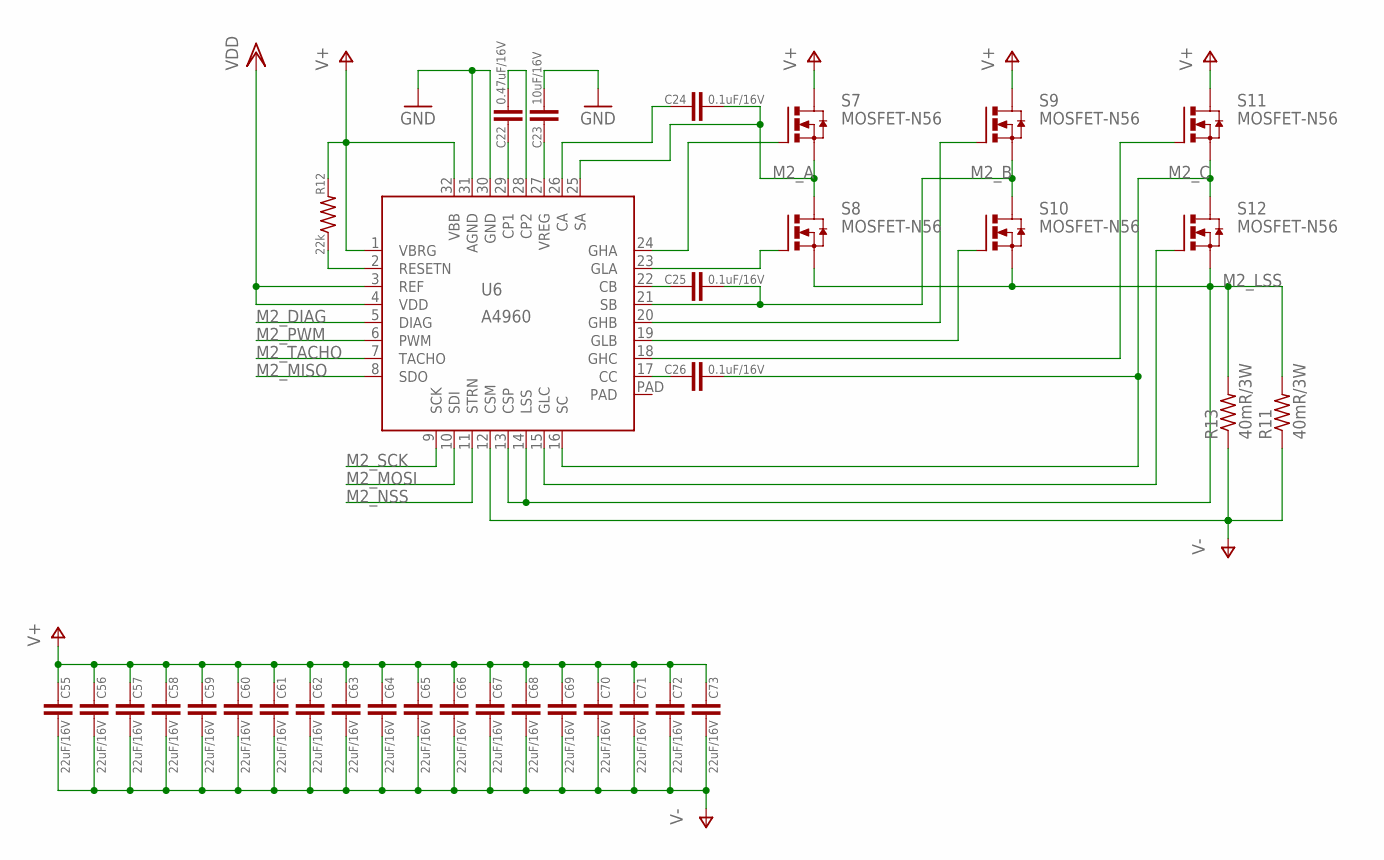
[picture p43: schematic Tortilla.sch, sheet 4]

Parts:
C22: 0.47uF/16V; 0603
C23: 10uF/16V; 0805
C24, C25, C26: 0.1uF/16V; 0603
C55, C56, C57, C58, C59, C60, C61, C62, C63, C64, C65, C66, C67, C68, C69, C70, C71, C72, C73: 22uF/16V; 1206
R11, R13: 40mR/3W; R2512
R12: 22k; 0603
S7, S8, S9, S10, S11, S12: MOSFET-N56; SON-5X6
U6: A4960; LQFP32-THERMPAD

Connections:
GND: C23.2, U6.30 (GND), U6.31 (AGND); also elsewhere on the board
M2_A: C24.2, S7.S1 (S), S7.S2 (S), S7.S3 (S), S8.D, U6.25 (SA)
M2_B: C25.2, S9.S1 (S), S9.S2 (S), S9.S3 (S), S10.D, U6.21 (SB)
M2_C: C26.2, S11.S1 (S), S11.S2 (S), S11.S3 (S), S12.D, U6.16 (SC)
M2_DIAG: U6.5 (DIAG); also elsewhere on the board
M2_LSS: R11.2, R13.2, S8.S1 (S), S8.S2 (S), S8.S3 (S), S10.S1 (S), S10.S2 (S), S10.S3 (S), S12.S1 (S), S12.S2 (S), S12.S3 (S), U6.13 (CSP), U6.14 (LSS)
M2_MISO: U6.8 (SDO); also elsewhere on the board
M2_MOSI: U6.10 (SDI); also elsewhere on the board
M2_NSS: U6.11 (STRN); also elsewhere on the board
M2_PWM: U6.6 (PWM); also elsewhere on the board
M2_SCK: U6.9 (SCK); also elsewhere on the board
M2_TACHO: U6.7 (TACHO); also elsewhere on the board
unnamed: C22.2, U6.28 (CP2)
unnamed: C22.1, U6.29 (CP1)
unnamed: C23.1, U6.27 (VREG)
unnamed: S7.G, U6.24 (GHA)
unnamed: S8.G, U6.23 (GLA)
unnamed: C24.1, U6.26 (CA)
unnamed: S9.G, U6.20 (GHB)
unnamed: S10.G, U6.19 (GLB)
unnamed: C25.1, U6.22 (CB)
unnamed: S11.G, U6.18 (GHC)
unnamed: S12.G, U6.15 (GLC)
unnamed: C26.1, U6.17 (CC)
unnamed: R12.1, U6.2 (RESETN)
V+: C55.1, C56.1, C57.1, C58.1, C59.1, C60.1, C61.1, C62.1, C63.1, C64.1, C65.1, C66.1, C67.1, C68.1, C69.1, C70.1, C71.1, C72.1, C73.1, R12.2, S7.D, S9.D, S11.D, U6.1 (VBRG), U6.32 (VBB); also elsewhere on the board
V-: C55.2, C56.2, C57.2, C58.2, C59.2, C60.2, C61.2, C62.2, C63.2, C64.2, C65.2, C66.2, C67.2, C68.2, C69.2, C70.2, C71.2, C72.2, C73.2, R11.1, R13.1, U6.12 (CSM); also elsewhere on the board
VDD: U6.3 (REF), U6.4 (VDD); also elsewhere on the board

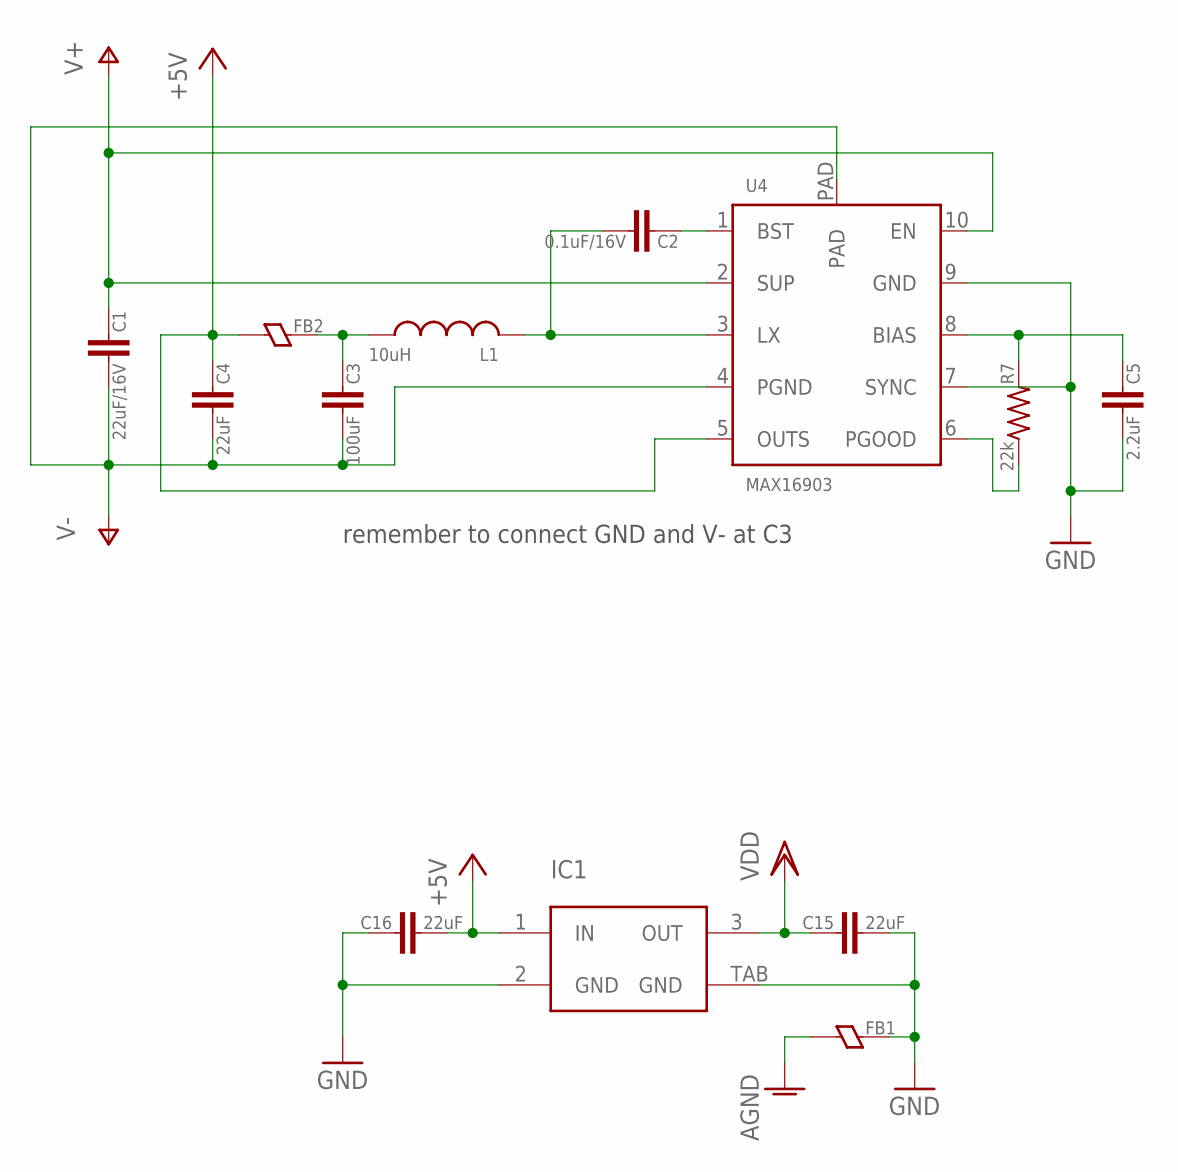
[picture p44: schematic Tortilla.sch, sheet 5]

Parts:
C1: 22uF/16V; 0805
C2: 0.1uF/16V; 0603
C3: 100uF; 1206
C4, C15, C16: 22uF; 0805
C5: 2.2uF; 0603
FB1, FB2: FERRITE0603; 0603
IC1: MCP1826S; SOT223-3L
L1: 10uH; TAIYO-YUDEN_NR30
R7: 22k; 0603
U4: MAX16903; TDFN-10

Connections:
+5V: C4.1, C16.2, FB2.1, IC1.1 (IN), U4.5 (OUTS); also elsewhere on the board
AGND: FB1.1; also elsewhere on the board
GND: C5.2, C15.2, C16.1, FB1.2, IC1.2 (GND), IC1.TAB (GND), U4.7 (SYNC), U4.9 (GND); also elsewhere on the board
unnamed: C2.1, U4.1 (BST)
unnamed: C2.2, L1.2, U4.3 (LX)
unnamed: C3.1, FB2.2, L1.1
unnamed: C5.1, R7.2, U4.8 (BIAS)
unnamed: R7.1, U4.6 (PGOOD)
V+: C1.1, U4.2 (SUP), U4.10 (EN); also elsewhere on the board
V-: C1.2, C3.2, C4.2, U4.4 (PGND), U4.PAD; also elsewhere on the board
VDD: C15.1, IC1.3 (OUT); also elsewhere on the board

Notes on the sheet:
remember to connect GND and V- at C3

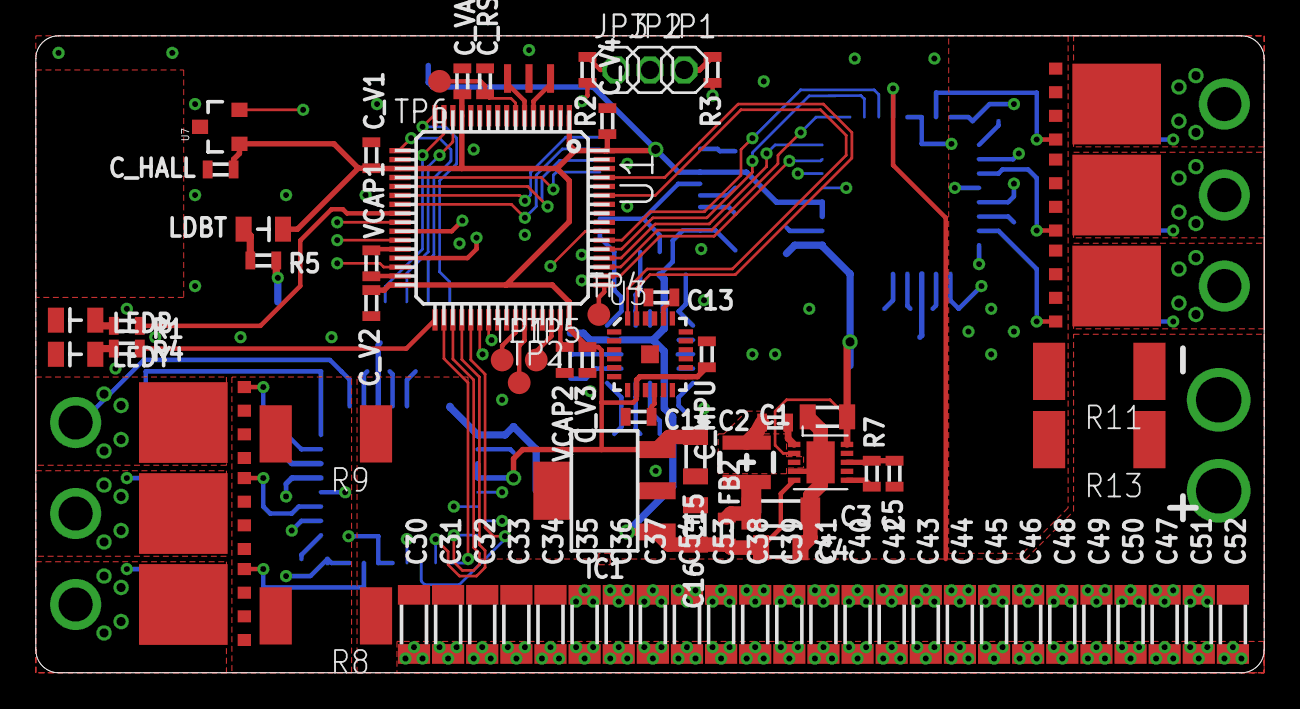
[picture p45: board Tortilla.brd from above]

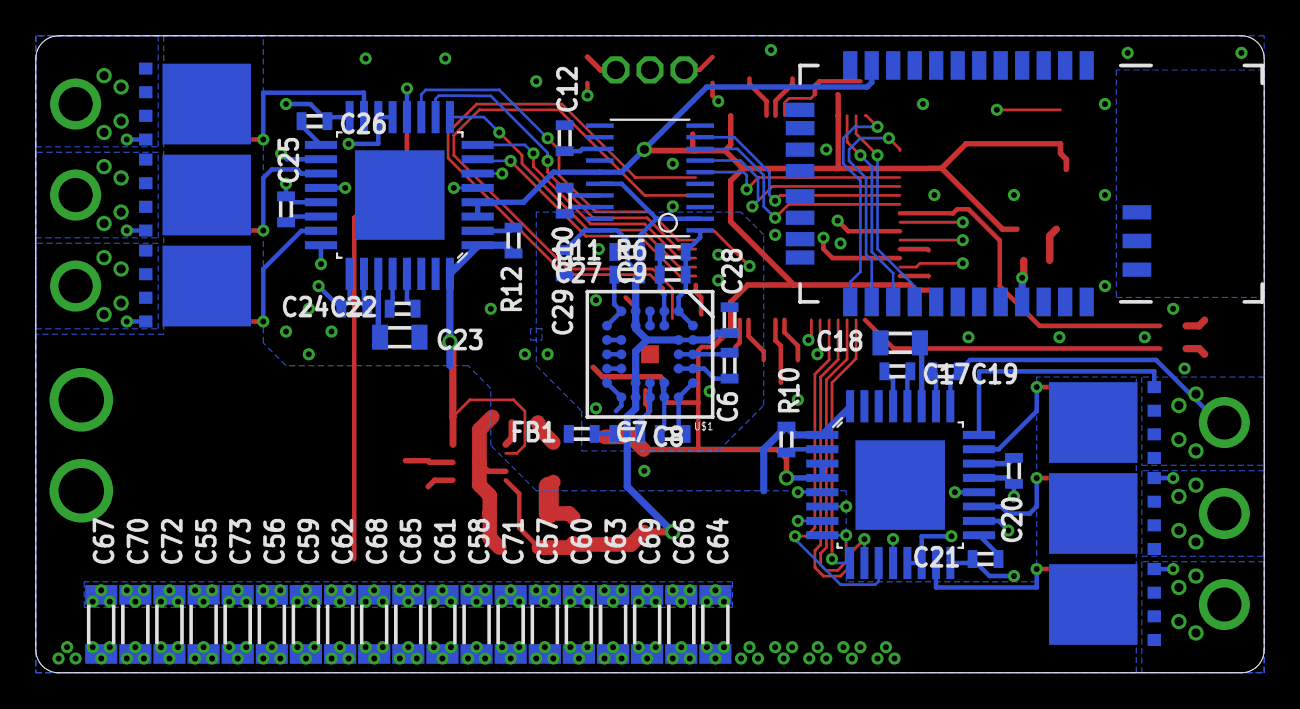
[picture p46: board Tortilla.brd from below]

Board: 4 copper layers, 68.6 x 35.6 mm, 133 parts (54 on the bottom side), 102 nets.
