GHF/gyroking/board/board.h

/*
    ChibiOS/RT - Copyright (C) 2006,2007,2008,2009,2010,
                 2011,2012 Giovanni Di Sirio.
    Modifications (C) 2012 Xo Wang

    This file is part of ChibiOS/RT.

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
                                      ---

    A special exception to the GPL can be applied should you wish to distribute
    a combined work that includes ChibiOS/RT, without being obliged to provide
    the source code for any proprietary components. See the file exception.txt
    for full details of how and when the exception can be applied.
*/

#ifndef _BOARD_H_
#define _BOARD_H_

/*
 * Setup for Gyro King Tortilla board (based on STMicroelectronics STM32F4-Discovery board files).
 */

/*
 * Board identifier.
 */
#define BOARD_TORTILLA_V2_0
#define BOARD_NAME              "Tortilla v2.0 (C) 2012 Xo Wang"

/*
 * Board frequencies.
 * NOTE: The LSE crystal is not fitted by default on the board.
 */
#define STM32_LSECLK            0
#define STM32_HSECLK            8000000

/*
 * Board voltages.
 * Required for performance limits calculation.
 */
#define STM32_VDD               300

/*
 * MCU type as defined in the ST header file stm32f4xx.h.
 */
#define STM32F4XX

/*
 * IO pins assignments.
 */
#define GPIOA_BT_CTS            0
#define GPIOA_BT_RTS            1
#define GPIOA_BT_TX             2
#define GPIOA_BT_RX             3
#define GPIOA_ADC_NSS           4
#define GPIOA_ADC_SCK           5
#define GPIOA_ADC_MISO          6
#define GPIOA_ADC_MOSI          7
#define GPIOA_U1_TX             9
#define GPIOA_U1_RX             10
#define GPIOA_SWDIO             13
#define GPIOA_SWCLK             14
#define GPIOA_M2_TACHO          15

#define GPIOB_LED1              0
#define GPIOB_M1_PWM            1
#define GPIOB_HALL              3
#define GPIOB_MPU_SDA           7
#define GPIOB_MPU_SCL           8
#define GPIOB_LED2              10
#define GPIOB_M1_TACHO          11
#define GPIOB_LEDY              12
#define GPIOB_M1_SCK            13
#define GPIOB_M1_MISO           14
#define GPIOB_M1_MOSI           15

#define GPIOC_LEDB              4
#define GPIOC_M1_DIAG           5
#define GPIOC_M1_NSS            6
#define GPIOC_M2_DIAG           7
#define GPIOC_M2_PWM            8
#define GPIOC_M2_SCK            10
#define GPIOC_M2_MISO           11
#define GPIOC_M2_MOSI           12

#define GPIOD_OSC_IN            0
#define GPIOD_OSC_OUT           1
#define GPIOD_M2_NSS            2

/*
 * I/O ports initial setup, this configuration is established soon after reset
 * in the initialization code.
 * Please refer to the STM32 Reference Manual for details.
 */
#define PIN_MODE_INPUT(n)           (0U << ((n) * 2))
#define PIN_MODE_OUTPUT(n)          (1U << ((n) * 2))
#define PIN_MODE_ALTERNATE(n)       (2U << ((n) * 2))
#define PIN_MODE_ANALOG(n)          (3U << ((n) * 2))
#define PIN_OTYPE_PUSHPULL(n)       (0U << (n))
#define PIN_OTYPE_OPENDRAIN(n)      (1U << (n))
#define PIN_OSPEED_2M(n)            (0U << ((n) * 2))
#define PIN_OSPEED_25M(n)           (1U << ((n) * 2))
#define PIN_OSPEED_50M(n)           (2U << ((n) * 2))
#define PIN_OSPEED_100M(n)          (3U << ((n) * 2))
#define PIN_PUDR_FLOATING(n)        (0U << ((n) * 2))
#define PIN_PUDR_PULLUP(n)          (1U << ((n) * 2))
#define PIN_PUDR_PULLDOWN(n)        (2U << ((n) * 2))
#define PIN_AFIO_AF(n, v)           ((v##U) << ((n % 8) * 4))

/*
 * Port A setup.
 */
#define VAL_GPIOA_MODER     (PIN_MODE_ALTERNATE(GPIOA_BT_CTS) |             \
                             PIN_MODE_ALTERNATE(GPIOA_BT_RTS) |             \
                             PIN_MODE_ALTERNATE(GPIOA_BT_TX) |              \
                             PIN_MODE_ALTERNATE(GPIOA_BT_RX) |              \
                             PIN_MODE_OUTPUT(GPIOA_ADC_NSS) |               \
                             PIN_MODE_ALTERNATE(GPIOA_ADC_SCK) |            \
                             PIN_MODE_ALTERNATE(GPIOA_ADC_MISO) |           \
                             PIN_MODE_ALTERNATE(GPIOA_ADC_MOSI) |           \
                             PIN_MODE_INPUT(8) |                            \
                             PIN_MODE_ALTERNATE(GPIOA_U1_TX) |              \
                             PIN_MODE_ALTERNATE(GPIOA_U1_RX) |              \
                             PIN_MODE_INPUT(11) |                           \
                             PIN_MODE_INPUT(12) |                           \
                             PIN_MODE_ALTERNATE(GPIOA_SWDIO) |              \
                             PIN_MODE_ALTERNATE(GPIOA_SWCLK) |              \
                             PIN_MODE_ALTERNATE(GPIOA_M2_TACHO))
#define VAL_GPIOA_OTYPER    0x00000000
#define VAL_GPIOA_OSPEEDR   0xFFFFFFFF
#define VAL_GPIOA_PUPDR     (PIN_PUDR_FLOATING(GPIOA_BT_CTS) |              \
                             PIN_PUDR_FLOATING(GPIOA_BT_RTS) |              \
                             PIN_PUDR_FLOATING(GPIOA_BT_TX) |               \
                             PIN_PUDR_FLOATING(GPIOA_BT_RX) |               \
                             PIN_PUDR_FLOATING(GPIOA_ADC_NSS) |             \
                             PIN_PUDR_FLOATING(GPIOA_ADC_SCK) |             \
                             PIN_PUDR_FLOATING(GPIOA_ADC_MISO) |            \
                             PIN_PUDR_FLOATING(GPIOA_ADC_MOSI) |            \
                             PIN_PUDR_PULLUP(8) |                           \
                             PIN_PUDR_FLOATING(GPIOA_U1_TX) |               \
                             PIN_PUDR_FLOATING(GPIOA_U1_RX) |               \
                             PIN_PUDR_PULLUP(11) |                          \
                             PIN_PUDR_PULLUP(12) |                          \
                             PIN_PUDR_PULLUP(GPIOA_SWDIO) |                 \
                             PIN_PUDR_PULLDOWN(GPIOA_SWCLK) |               \
                             PIN_PUDR_FLOATING(GPIOA_M2_TACHO))
#define VAL_GPIOA_ODR       0xFFFFFFFF
#define VAL_GPIOA_AFRL      (PIN_AFIO_AF(GPIOA_BT_CTS, 7) |                 \
                             PIN_AFIO_AF(GPIOA_BT_RTS, 7) |                 \
                             PIN_AFIO_AF(GPIOA_BT_TX, 7) |                  \
                             PIN_AFIO_AF(GPIOA_BT_RX, 7) |                  \
                             PIN_AFIO_AF(GPIOA_ADC_SCK, 5) |                \
                             PIN_AFIO_AF(GPIOA_ADC_MISO, 5) |               \
                             PIN_AFIO_AF(GPIOA_ADC_MOSI, 5))
#define VAL_GPIOA_AFRH      (PIN_AFIO_AF(GPIOA_U1_TX, 7) |                  \
                             PIN_AFIO_AF(GPIOA_U1_RX, 7) |                  \
                             PIN_AFIO_AF(GPIOA_SWDIO, 0) |                  \
                             PIN_AFIO_AF(GPIOA_SWCLK, 0) |                  \
                             PIN_AFIO_AF(GPIOA_M2_TACHO, 1))

/*
 * Port B setup.
 */
#define VAL_GPIOB_MODER     (PIN_MODE_OUTPUT(GPIOB_LED1) |                  \
                             PIN_MODE_ALTERNATE(GPIOB_M1_PWM) |             \
                             PIN_MODE_INPUT(2) |                            \
                             PIN_MODE_ALTERNATE(GPIOB_HALL) |               \
                             PIN_MODE_INPUT(4) |                            \
                             PIN_MODE_INPUT(5) |                            \
                             PIN_MODE_INPUT(6) |                            \
                             PIN_MODE_ALTERNATE(GPIOB_MPU_SDA) |            \
                             PIN_MODE_ALTERNATE(GPIOB_MPU_SCL) |            \
                             PIN_MODE_INPUT(9) |                            \
                             PIN_MODE_OUTPUT(GPIOB_LED2) |                  \
                             PIN_MODE_ALTERNATE(GPIOB_M1_TACHO) |           \
                             PIN_MODE_OUTPUT(GPIOB_LEDY) |                  \
                             PIN_MODE_ALTERNATE(GPIOB_M1_SCK) |             \
                             PIN_MODE_ALTERNATE(GPIOB_M1_MISO) |            \
                             PIN_MODE_ALTERNATE(GPIOB_M1_MOSI))
#define VAL_GPIOB_OTYPER    (PIN_OTYPE_OPENDRAIN(GPIOB_MPU_SDA) |           \
                             PIN_OTYPE_OPENDRAIN(GPIOB_MPU_SCL))
#define VAL_GPIOB_OSPEEDR   0xFFFFFFFF
#define VAL_GPIOB_PUPDR     (PIN_PUDR_FLOATING(GPIOB_LED1) |                \
                             PIN_PUDR_FLOATING(GPIOB_M1_PWM) |              \
                             PIN_PUDR_PULLUP(2) |                           \
                             PIN_PUDR_FLOATING(GPIOB_HALL) |                \
                             PIN_PUDR_PULLUP(4) |                           \
                             PIN_PUDR_PULLUP(5) |                           \
                             PIN_PUDR_PULLUP(6) |                           \
                             PIN_PUDR_PULLUP(GPIOB_MPU_SDA) |               \
                             PIN_PUDR_PULLUP(GPIOB_MPU_SCL) |               \
                             PIN_PUDR_PULLUP(9) |                           \
                             PIN_PUDR_FLOATING(GPIOB_LED2) |                \
                             PIN_PUDR_FLOATING(GPIOB_M1_TACHO) |            \
                             PIN_PUDR_FLOATING(GPIOB_LEDY) |                \
                             PIN_PUDR_FLOATING(GPIOB_M1_SCK) |              \
                             PIN_PUDR_FLOATING(GPIOB_M1_SCK) |              \
                             PIN_PUDR_FLOATING(GPIOB_M1_MOSI))
#define VAL_GPIOB_ODR       0xFFFFFFFF
#define VAL_GPIOB_AFRL      (PIN_AFIO_AF(GPIOB_M1_PWM, 2) |                 \
                             PIN_AFIO_AF(GPIOB_HALL, 1) |                   \
                             PIN_AFIO_AF(GPIOB_MPU_SDA, 4))
#define VAL_GPIOB_AFRH      (PIN_AFIO_AF(GPIOB_MPU_SCL, 4) |                \
                             PIN_AFIO_AF(GPIOB_M1_TACHO, 1) |               \
                             PIN_AFIO_AF(GPIOB_M1_SCK, 5) |                 \
                             PIN_AFIO_AF(GPIOB_M1_MISO, 5) |                \
                             PIN_AFIO_AF(GPIOB_M1_MOSI, 5))

/*
 * Port C setup.
 */
#define VAL_GPIOC_MODER     (PIN_MODE_INPUT(0) |                            \
                             PIN_MODE_INPUT(1) |                            \
                             PIN_MODE_INPUT(2) |                            \
                             PIN_MODE_INPUT(3) |                            \
                             PIN_MODE_OUTPUT(GPIOC_LEDB) |                  \
                             PIN_MODE_INPUT(GPIOC_M1_DIAG) |                \
                             PIN_MODE_OUTPUT(GPIOC_M1_NSS) |                \
                             PIN_MODE_INPUT(GPIOC_M2_DIAG) |                \
                             PIN_MODE_ALTERNATE(GPIOC_M2_PWM) |             \
                             PIN_MODE_INPUT(9) |                            \
                             PIN_MODE_ALTERNATE(GPIOC_M2_SCK) |             \
                             PIN_MODE_ALTERNATE(GPIOC_M2_MISO) |            \
                             PIN_MODE_ALTERNATE(GPIOC_M2_MOSI) |            \
                             PIN_MODE_INPUT(13) |                           \
                             PIN_MODE_INPUT(14) |                           \
                             PIN_MODE_INPUT(15))
#define VAL_GPIOC_OTYPER    0x00000000
#define VAL_GPIOC_OSPEEDR   0xFFFFFFFF
#define VAL_GPIOC_PUPDR     (PIN_PUDR_PULLUP(0) |                           \
                             PIN_PUDR_PULLUP(1) |                           \
                             PIN_PUDR_PULLUP(2) |                           \
                             PIN_PUDR_PULLUP(3) |                           \
                             PIN_PUDR_FLOATING(GPIOC_LEDB) |                \
                             PIN_PUDR_FLOATING(GPIOC_M1_DIAG) |             \
                             PIN_PUDR_FLOATING(GPIOC_M1_NSS) |              \
                             PIN_PUDR_FLOATING(GPIOC_M2_DIAG) |             \
                             PIN_PUDR_FLOATING(GPIOC_M2_PWM) |              \
                             PIN_PUDR_PULLUP(9) |                           \
                             PIN_PUDR_FLOATING(GPIOC_M2_SCK) |              \
                             PIN_PUDR_FLOATING(GPIOC_M2_MISO) |             \
                             PIN_PUDR_FLOATING(GPIOC_M2_MOSI) |             \
                             PIN_PUDR_PULLUP(13) |                          \
                             PIN_PUDR_PULLUP(14) |                          \
                             PIN_PUDR_PULLUP(15))
#define VAL_GPIOC_ODR       0xFFFFFFFF
#define VAL_GPIOC_AFRL      0x00000000
#define VAL_GPIOC_AFRH      (PIN_AFIO_AF(GPIOC_M2_PWM, 2) |                 \
                             PIN_AFIO_AF(GPIOC_M2_SCK, 6) |                 \
                             PIN_AFIO_AF(GPIOC_M2_MISO, 6) |                \
                             PIN_AFIO_AF(GPIOC_M2_MOSI, 6))

/*
 * Port D setup.
 */
#define VAL_GPIOD_MODER     (PIN_MODE_INPUT(GPIOD_OSC_IN) |                 \
                             PIN_MODE_INPUT(GPIOD_OSC_OUT) |                \
                             PIN_MODE_OUTPUT(GPIOD_M2_NSS) |                \
                             PIN_MODE_INPUT(3) |                            \
                             PIN_MODE_INPUT(4) |                            \
                             PIN_MODE_INPUT(5) |                            \
                             PIN_MODE_INPUT(6) |                            \
                             PIN_MODE_INPUT(7) |                            \
                             PIN_MODE_INPUT(8) |                            \
                             PIN_MODE_INPUT(9) |                            \
                             PIN_MODE_INPUT(10) |                           \
                             PIN_MODE_INPUT(11) |                           \
                             PIN_MODE_INPUT(12) |                           \
                             PIN_MODE_INPUT(13) |                           \
                             PIN_MODE_INPUT(14) |                           \
                             PIN_MODE_INPUT(15))
#define VAL_GPIOD_OTYPER    0x00000000
#define VAL_GPIOD_OSPEEDR   0xFFFFFFFF
#define VAL_GPIOD_PUPDR     (PIN_PUDR_FLOATING(0) |                         \
                             PIN_PUDR_FLOATING(1) |                         \
                             PIN_PUDR_FLOATING(2) |                         \
                             PIN_PUDR_PULLUP(3) |                           \
                             PIN_PUDR_PULLUP(4) |                           \
                             PIN_PUDR_PULLUP(5) |                           \
                             PIN_PUDR_PULLUP(6) |                           \
                             PIN_PUDR_PULLUP(7) |                           \
                             PIN_PUDR_PULLUP(8) |                           \
                             PIN_PUDR_PULLUP(9) |                           \
                             PIN_PUDR_PULLUP(10) |                          \
                             PIN_PUDR_PULLUP(11) |                          \
                             PIN_PUDR_PULLUP(12) |                          \
                             PIN_PUDR_PULLUP(13) |                          \
                             PIN_PUDR_PULLUP(14) |                          \
                             PIN_PUDR_PULLUP(15))
#define VAL_GPIOD_ODR       0xFFFFFFFF
#define VAL_GPIOD_AFRL      0x00000000
#define VAL_GPIOD_AFRH      0x00000000

/*
 * Port E setup.
 */
#define VAL_GPIOE_MODER     0x00000000
#define VAL_GPIOE_OTYPER    0x00000000
#define VAL_GPIOE_OSPEEDR   0xFFFFFFFF
#define VAL_GPIOE_PUPDR     (PIN_PUDR_PULLUP(0) |                           \
                             PIN_PUDR_PULLUP(1) |                           \
                             PIN_PUDR_PULLUP(2) |                           \
                             PIN_PUDR_PULLUP(3) |                           \
                             PIN_PUDR_PULLUP(4) |                           \
                             PIN_PUDR_PULLUP(5) |                           \
                             PIN_PUDR_PULLUP(6) |                           \
                             PIN_PUDR_PULLUP(7) |                           \
                             PIN_PUDR_PULLUP(8) |                           \
                             PIN_PUDR_PULLUP(9) |                           \
                             PIN_PUDR_PULLUP(10) |                          \
                             PIN_PUDR_PULLUP(11) |                          \
                             PIN_PUDR_PULLUP(12) |                          \
                             PIN_PUDR_PULLUP(13) |                          \
                             PIN_PUDR_PULLUP(14) |                          \
                             PIN_PUDR_PULLUP(15))
#define VAL_GPIOE_ODR       0xFFFFFFFF
#define VAL_GPIOE_AFRL      0x00000000
#define VAL_GPIOE_AFRH      0x00000000

/*
 * Port F setup.
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
                             PIN_PUDR_PULLUP(14) |                          \
                             PIN_PUDR_PULLUP(15))
#define VAL_GPIOH_ODR       0xFFFFFFFF
#define VAL_GPIOH_AFRL      0x00000000
#define VAL_GPIOH_AFRH      0x00000000

/*
 * Port I setup.
 */
#define VAL_GPIOI_MODER     0x00000000
#define VAL_GPIOI_OTYPER    0x00000000
#define VAL_GPIOI_OSPEEDR   0xFFFFFFFF
#define VAL_GPIOI_PUPDR     (PIN_PUDR_PULLUP(0) |                           \
                             PIN_PUDR_PULLUP(1) |                           \
                             PIN_PUDR_PULLUP(2) |                           \
                             PIN_PUDR_PULLUP(3) |                           \
                             PIN_PUDR_PULLUP(4) |                           \
                             PIN_PUDR_PULLUP(5) |                           \
                             PIN_PUDR_PULLUP(6) |                           \
                             PIN_PUDR_PULLUP(7) |                           \
                             PIN_PUDR_PULLUP(8) |                           \
                             PIN_PUDR_PULLUP(9) |                           \
                             PIN_PUDR_PULLUP(10) |                          \
                             PIN_PUDR_PULLUP(11) |                          \
                             PIN_PUDR_PULLUP(12) |                          \
                             PIN_PUDR_PULLUP(13) |                          \
                             PIN_PUDR_PULLUP(14) |                          \
                             PIN_PUDR_PULLUP(15))
#define VAL_GPIOI_ODR       0xFFFFFFFF
#define VAL_GPIOI_AFRL      0x00000000
#define VAL_GPIOI_AFRH      0x00000000

#if !defined(_FROM_ASM_)
#ifdef __cplusplus
extern "C" {
#endif
  void boardInit(void);
#ifdef __cplusplus
}
#endif
#endif /* _FROM_ASM_ */

#endif /* _BOARD_H_ */
