GHF/gyroking/src/Tortilla_control.cpp

/*
 *  Copyright (C) 2012 Xo Wang, Aaron Fan
 *
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
 *  Except as contained in this notice, the name of Xo Wang shall not be
 *  used in advertising or otherwise to promote the sale, use or other dealings
 *  in this Software without prior written authorization from Xo Wang.
 */

#include "ch.h"
#include "hal.h"

#include "Tortilla.h"
#include "chprintf.h"
#include "A4960.h"
#include "ADS1259.h"

#include <algorithm>

#include <stdint.h>
#include <cmath>

Tortilla::Tortilla(A4960 &m1, A4960 &m2, ADS1259 &adc, ICUDriver *icup, SerialDriver *sdp) :
        m1(m1),
        m2(m2),
        adc(adc),
        icup(icup),
        sdp(sdp),
        gyroBias(0),
        lastRate(0),
        currentRate(0),
        theta(0),
        throttle(0),
        reversed(false),
        joyAngle(0),
        joyMag(0),
        gyroTrim(0),
        translationTrim(0) {
}

void Tortilla::initGyroBias() {
    int32_t adcReading;
    int64_t sumReadings = 0;
    size_t numReadings = 0;
    systime_t ticks = chTimeNow();
    for (size_t i = 0; i < 6000U; i++) {
        if (adc.read(adcReading) && i >= 1000) {
            numReadings++;
            sumReadings += adcReading;
        }

        ticks += MS2ST(1);
        chThdSleepUntil(ticks);
    }
    gyroBias = sumReadings / numReadings + 1100;
}

static constexpr float SCALE_RAW_TO_RADSEC = float(64000.0 * (M_PI / 180.0) / double(0x7FFFFFUL));

static constexpr size_t LOOP_DELAY_US = 1000;
static constexpr systime_t LOOP_DELAY = US2ST(LOOP_DELAY_US);
static constexpr float DT = LOOP_DELAY_US / 1000000.0;

template<typename T, typename Scalar>
static inline T lerp(const T &a, const T &b, Scalar t) {
    return a + t * (b - a);
}

void Tortilla::fastLoop() {
    initGyroBias();
    palClearPad(GPIOB, GPIOB_LEDY);
    palClearPad(GPIOB, GPIOB_LED1);

    systime_t ticks = chTimeNow();
    while (true) {
        int32_t adcReading;
        if (adc.read(adcReading)) {
            const float rate = SCALE_RAW_TO_RADSEC * (adcReading - gyroBias) + gyroTrim;
            const float filteredRate = lerp(currentRate, rate, 0.1f);

            lastRate = currentRate;
            currentRate = filteredRate;
//            theta += (currentRate) * DT; // euler integration
            theta += 0.5f * (currentRate + lastRate) * DT; // trapezoidal integration
            theta = ::remainderf(theta, M_TWOPI);
        }

        pwmcnt_t m1Speed = throttle;
        pwmcnt_t m2Speed = throttle;

        const bool blue = ::fabsf(theta) < float(M_PI / 6.0);
        palWritePad(GPIOC, GPIOC_LEDB, blue);
        palWritePad(GPIOB, GPIOB_LED2, blue);
        if (joyMag == 0.f) {
            const bool yellow = !blue && ::fabsf(::remainderf(theta * 3.f, M_TWOPI)) < float(M_PI_2);
            palWritePad(GPIOB, GPIOB_LEDY, yellow);
            palWritePad(GPIOB, GPIOB_LED1, yellow);
        } else {
            // trim angle to advance by
            const float thetaOffset = (reversed ? -1.f : 1.f) * currentRate * translationTrim * DT;
            // joystick angle in robot coords
            const float joyRel = ::remainderf(joyAngle - theta + thetaOffset, M_TWOPI);
            const float joyRelOpp = ::remainderf(joyRel + M_PI, M_TWOPI);
            const float slipRange = std::max(0.05f, ::fabsf(joyMag * float(M_PI / 30.0)));

            if (::fabsf(joyRel) < slipRange) {
                m1Speed = PWM_PERIOD;
                m2Speed = std::max(1, throttle / 30);
            } else if (::fabsf(joyRelOpp) < slipRange) {
                m1Speed = std::max(1, throttle / 30);
                m2Speed = PWM_PERIOD;
            }

            const bool yellow = ::fabsf(::remainderf(joyAngle - theta, M_TWOPI))
                    < std::max(0.2f, ::fabsf(joyMag * float(M_PI / 3.0)));
            palWritePad(GPIOB, GPIOB_LEDY, yellow);
            palWritePad(GPIOB, GPIOB_LED1, yellow);
        }

        m1.setWidth(m1Speed);
        m2.setWidth(m2Speed);

        ticks += LOOP_DELAY;
        chThdSleepUntil(ticks);
    }
}
