GHF/gyroking/ChibiOS/os/hal/platforms/STM32/icu_lld.c

/*
    ChibiOS/RT - Copyright (C) 2006,2007,2008,2009,2010,
                 2011,2012 Giovanni Di Sirio.

    This file is part of ChibiOS/RT.

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
                                      ---

    A special exception to the GPL can be applied should you wish to distribute
    a combined work that includes ChibiOS/RT, without being obliged to provide
    the source code for any proprietary components. See the file exception.txt
    for full details of how and when the exception can be applied.
*/

/**
 * @file    STM32/icu_lld.c
 * @brief   STM32 ICU subsystem low level driver header.
 *
 * @addtogroup ICU
 * @{
 */

#include "ch.h"
#include "hal.h"

#if HAL_USE_ICU || defined(__DOXYGEN__)

/*===========================================================================*/
/* Driver exported variables.                                                */
/*===========================================================================*/

/**
 * @brief   ICUD1 driver identifier.
 * @note    The driver ICUD1 allocates the complex timer TIM1 when enabled.
 */
#if STM32_ICU_USE_TIM1 || defined(__DOXYGEN__)
ICUDriver ICUD1;
#endif

/**
 * @brief   ICUD2 driver identifier.
 * @note    The driver ICUD1 allocates the timer TIM2 when enabled.
 */
#if STM32_ICU_USE_TIM2 || defined(__DOXYGEN__)
ICUDriver ICUD2;
#endif

/**
 * @brief   ICUD3 driver identifier.
 * @note    The driver ICUD1 allocates the timer TIM3 when enabled.
 */
#if STM32_ICU_USE_TIM3 || defined(__DOXYGEN__)
ICUDriver ICUD3;
#endif

/**
 * @brief   ICUD4 driver identifier.
 * @note    The driver ICUD4 allocates the timer TIM4 when enabled.
 */
#if STM32_ICU_USE_TIM4 || defined(__DOXYGEN__)
ICUDriver ICUD4;
#endif

/**
 * @brief   ICUD5 driver identifier.
 * @note    The driver ICUD5 allocates the timer TIM5 when enabled.
 */
#if STM32_ICU_USE_TIM5 || defined(__DOXYGEN__)
ICUDriver ICUD5;
#endif

/**
 * @brief   ICUD8 driver identifier.
 * @note    The driver ICUD8 allocates the timer TIM8 when enabled.
 */
#if STM32_ICU_USE_TIM8 || defined(__DOXYGEN__)
ICUDriver ICUD8;
#endif

/*===========================================================================*/
/* Driver local variables.                                                   */
/*===========================================================================*/

/*===========================================================================*/
/* Driver local functions.                                                   */
/*===========================================================================*/

/**
 * @brief   Shared IRQ handler.
 *
 * @param[in] icup      pointer to the @p ICUDriver object
 */
static void icu_lld_serve_interrupt(ICUDriver *icup) {
  uint16_t sr;

  sr = icup->tim->SR & icup->tim->DIER;
  icup->tim->SR = 0;
  if ((sr & TIM_SR_CC1IF) != 0)
    _icu_isr_invoke_ch0_edge_cb(icup);
  if ((sr & TIM_SR_CC2IF) != 0)
    _icu_isr_invoke_ch1_edge_cb(icup);
  if ((sr & TIM_SR_CC3IF) != 0)
    _icu_isr_invoke_ch2_edge_cb(icup);
  if ((sr & TIM_SR_CC4IF) != 0)
    _icu_isr_invoke_ch3_edge_cb(icup);
  if ((sr & TIM_SR_UIF) != 0)
    _icu_isr_invoke_overflow_cb(icup);
}

/*===========================================================================*/
/* Driver interrupt handlers.                                                */
/*===========================================================================*/

#if STM32_ICU_USE_TIM1
/**
 * @brief   TIM1 compare interrupt handler.
 * @note    It is assumed that the various sources are only activated if the
 *          associated callback pointer is not equal to @p NULL in order to not
 *          perform an extra check in a potentially critical interrupt handler.
 *
 * @isr
 */
CH_IRQ_HANDLER(TIM1_CC_IRQHandler) {

  CH_IRQ_PROLOGUE();

  icu_lld_serve_interrupt(&ICUD1);

  CH_IRQ_EPILOGUE();
}

/**
 * @brief   TIM1 compare interrupt handler.
 * @note    It is assumed that the various sources are only activated if the
 *          associated callback pointer is not equal to @p NULL in order to not
 *          perform an extra check in a potentially critical interrupt handler.
 *
 * @isr
 */
CH_IRQ_HANDLER(TIM1_UP_IRQHandler) {

  CH_IRQ_PROLOGUE();

  icu_lld_serve_interrupt(&ICUD1);

  CH_IRQ_EPILOGUE();
}
#endif /* STM32_ICU_USE_TIM1 */

#if STM32_ICU_USE_TIM2
/**
 * @brief   TIM2 interrupt handler.
 * @note    It is assumed that the various sources are only activated if the
 *          associated callback pointer is not equal to @p NULL in order to not
 *          perform an extra check in a potentially critical interrupt handler.
 *
 * @isr
 */
CH_IRQ_HANDLER(TIM2_IRQHandler) {

  CH_IRQ_PROLOGUE();

  icu_lld_serve_interrupt(&ICUD2);

  CH_IRQ_EPILOGUE();
}
#endif /* STM32_ICU_USE_TIM2 */

#if STM32_ICU_USE_TIM3
/**
 * @brief   TIM3 interrupt handler.
 * @note    It is assumed that the various sources are only activated if the
 *          associated callback pointer is not equal to @p NULL in order to not
 *          perform an extra check in a potentially critical interrupt handler.
 *
 * @isr
 */
CH_IRQ_HANDLER(TIM3_IRQHandler) {

  CH_IRQ_PROLOGUE();

  icu_lld_serve_interrupt(&ICUD3);

  CH_IRQ_EPILOGUE();
}
#endif /* STM32_ICU_USE_TIM3 */

#if STM32_ICU_USE_TIM4
/**
 * @brief   TIM4 interrupt handler.
 * @note    It is assumed that the various sources are only activated if the
 *          associated callback pointer is not equal to @p NULL in order to not
 *          perform an extra check in a potentially critical interrupt handler.
 *
 * @isr
 */
CH_IRQ_HANDLER(TIM4_IRQHandler) {

  CH_IRQ_PROLOGUE();

  icu_lld_serve_interrupt(&ICUD4);

  CH_IRQ_EPILOGUE();
}
#endif /* STM32_ICU_USE_TIM4 */

#if STM32_ICU_USE_TIM5
/**
 * @brief   TIM5 interrupt handler.
 * @note    It is assumed that the various sources are only activated if the
 *          associated callback pointer is not equal to @p NULL in order to not
 *          perform an extra check in a potentially critical interrupt handler.
 *
 * @isr
 */
CH_IRQ_HANDLER(TIM5_IRQHandler) {

  CH_IRQ_PROLOGUE();

  icu_lld_serve_interrupt(&ICUD5);

  CH_IRQ_EPILOGUE();
}
#endif /* STM32_ICU_USE_TIM5 */

#if STM32_ICU_USE_TIM8
/**
 * @brief   TIM8 compare interrupt handler.
 * @note    It is assumed that the various sources are only activated if the
 *          associated callback pointer is not equal to @p NULL in order to not
 *          perform an extra check in a potentially critical interrupt handler.
 *
 * @isr
 */
CH_IRQ_HANDLER(TIM8_CC_IRQHandler) {

  CH_IRQ_PROLOGUE();

  icu_lld_serve_interrupt(&ICUD8);

  CH_IRQ_EPILOGUE();
}

/**
 * @brief   TIM8 compare interrupt handler.
 * @note    It is assumed that the various sources are only activated if the
 *          associated callback pointer is not equal to @p NULL in order to not
 *          perform an extra check in a potentially critical interrupt handler.
 *
 * @isr
 */
CH_IRQ_HANDLER(TIM8_UP_IRQHandler) {

  CH_IRQ_PROLOGUE();

  icu_lld_serve_interrupt(&ICUD8);

  CH_IRQ_EPILOGUE();
}
#endif /* STM32_ICU_USE_TIM8 */

/*===========================================================================*/
/* Driver exported functions.                                                */
/*===========================================================================*/

/**
 * @brief   Low level ICU driver initialization.
 *
 * @notapi
 */
void icu_lld_init(void) {

#if STM32_ICU_USE_TIM1
  /* Driver initialization.*/
  icuObjectInit(&ICUD1);
  ICUD1.tim = STM32_TIM1;
#endif

#if STM32_ICU_USE_TIM2
  /* Driver initialization.*/
  icuObjectInit(&ICUD2);
  ICUD2.tim = STM32_TIM2;
#endif

#if STM32_ICU_USE_TIM3
  /* Driver initialization.*/
  icuObjectInit(&ICUD3);
  ICUD3.tim = STM32_TIM3;
#endif

#if STM32_ICU_USE_TIM4
  /* Driver initialization.*/
  icuObjectInit(&ICUD4);
  ICUD4.tim = STM32_TIM4;
#endif

#if STM32_ICU_USE_TIM5
  /* Driver initialization.*/
  icuObjectInit(&ICUD5);
  ICUD5.tim = STM32_TIM5;
#endif

#if STM32_ICU_USE_TIM8
  /* Driver initialization.*/
  icuObjectInit(&ICUD8);
  ICUD8.tim = STM32_TIM8;
#endif
}

/**
 * @brief   Configures and activates the ICU peripheral.
 *
 * @param[in] icup      pointer to the @p ICUDriver object
 *
 * @notapi
 */
void icu_lld_start(ICUDriver *icup) {
  uint32_t psc;

  if (icup->state == ICU_STOP) {
    /* Clock activation and timer reset.*/
#if STM32_ICU_USE_TIM1
    if (&ICUD1 == icup) {
      rccEnableTIM1(FALSE);
      rccResetTIM1();
      nvicEnableVector(TIM1_CC_IRQn,
                       CORTEX_PRIORITY_MASK(STM32_ICU_TIM1_IRQ_PRIORITY));
      nvicEnableVector(TIM1_UP_IRQn,
                       CORTEX_PRIORITY_MASK(STM32_ICU_TIM1_IRQ_PRIORITY));
      icup->clock = STM32_TIMCLK2;
    }
#endif
#if STM32_ICU_USE_TIM2
    if (&ICUD2 == icup) {
      rccEnableTIM2(FALSE);
      rccResetTIM2();
      nvicEnableVector(TIM2_IRQn,
                       CORTEX_PRIORITY_MASK(STM32_ICU_TIM2_IRQ_PRIORITY));
      icup->clock = STM32_TIMCLK1;
    }
#endif
#if STM32_ICU_USE_TIM3
    if (&ICUD3 == icup) {
      rccEnableTIM3(FALSE);
      rccResetTIM3();
      nvicEnableVector(TIM3_IRQn,
                       CORTEX_PRIORITY_MASK(STM32_ICU_TIM3_IRQ_PRIORITY));
      icup->clock = STM32_TIMCLK1;
    }
#endif
#if STM32_ICU_USE_TIM4
    if (&ICUD4 == icup) {
      rccEnableTIM4(FALSE);
      rccResetTIM4();
      nvicEnableVector(TIM4_IRQn,
                       CORTEX_PRIORITY_MASK(STM32_ICU_TIM4_IRQ_PRIORITY));
      icup->clock = STM32_TIMCLK1;
    }
#endif

#if STM32_ICU_USE_TIM5
    if (&ICUD5 == icup) {
      rccEnableTIM5(FALSE);
      rccResetTIM5();
      nvicEnableVector(TIM5_IRQn,
                       CORTEX_PRIORITY_MASK(STM32_ICU_TIM5_IRQ_PRIORITY));
      icup->clock = STM32_TIMCLK1;
    }
#endif
#if STM32_ICU_USE_TIM8
    if (&ICUD8 == icup) {
      rccEnableTIM8(FALSE);
      rccResetTIM8();
      nvicEnableVector(TIM8_CC_IRQn,
                       CORTEX_PRIORITY_MASK(STM32_ICU_TIM8_IRQ_PRIORITY));
      nvicEnableVector(TIM8_UP_IRQn,
                       CORTEX_PRIORITY_MASK(STM32_ICU_TIM8_IRQ_PRIORITY));
      icup->clock = STM32_TIMCLK2;
    }
#endif
  }
  else {
    /* Driver re-configuration scenario, it must be stopped first.*/
    icup->tim->CR1    = 0;                  /* Timer disabled.              */
    icup->tim->CR2    = 0;                  /* Timer options cleared.       */
    icup->tim->DIER   = 0;                  /* All IRQs disabled.           */
    icup->tim->SR     = 0;                  /* Clear eventual pending IRQs. */
    icup->tim->CCR[0] = 0;                  /* Comparator 1 disabled.       */
    icup->tim->CCR[1] = 0;                  /* Comparator 2 disabled.       */
    icup->tim->CCR[2] = 0;                  /* Comparator 3 disabled.       */
    icup->tim->CCR[3] = 0;                  /* Comparator 4 disabled.       */
    icup->tim->CNT    = 0;                  /* Counter reset to zero.       */
    icup->tim->SMCR   = 0;                  /* Disable slave mode           */
  }

  /* Timer configuration.*/
  psc = (icup->clock / icup->config->frequency) - 1;
  chDbgAssert((psc <= 0xFFFF) &&
              ((psc + 1) * icup->config->frequency) == icup->clock,
              "icu_lld_start(), #1", "invalid frequency");
  icup->tim->PSC  = (uint16_t)psc;
  icup->tim->ARR   = 0xFFFFFFFF;
  icup->tim->EGR |= TIM_EGR_UG;      /* generate update event to update PSC */

  /* CCMR1_CC1S = 01 = CH1 Input on TI1.
     CCMR1_CC2S = 01 = CH2 Input on TI2.*/
  icup->tim->CCMR1 = TIM_CCMR1_CC1S_0 |
                     TIM_CCMR1_CC2S_0;
  /* CCMR2_CC3S = 01 = CH3 Input on TI3.
     CCMR2_CC4S = 01 = CH4 Input on TI4.*/
  icup->tim->CCMR2 = TIM_CCMR2_CC3S_0 |
                     TIM_CCMR2_CC4S_0;
  /* Input capture on both edges */
  icup->tim->CCER = TIM_CCER_CC1E | TIM_CCER_CC1P | TIM_CCER_CC1NP |
                    TIM_CCER_CC2E | TIM_CCER_CC2P | TIM_CCER_CC2NP |
                    TIM_CCER_CC3E | TIM_CCER_CC3P | TIM_CCER_CC3NP |
                    TIM_CCER_CC4E | TIM_CCER_CC4P | TIM_CCER_CC4NP;
}

/**
 * @brief   Deactivates the ICU peripheral.
 *
 * @param[in] icup      pointer to the @p ICUDriver object
 *
 * @notapi
 */
void icu_lld_stop(ICUDriver *icup) {

  if (icup->state == ICU_READY) {
    /* Clock deactivation.*/
    icup->tim->CR1  = 0;                    /* Timer disabled.              */
    icup->tim->CR2  = 0;                    /* Reset timer config.          */
    icup->tim->DIER = 0;                    /* All IRQs disabled.           */
    icup->tim->SR   = 0;                    /* Clear eventual pending IRQs. */

#if STM32_ICU_USE_TIM1
    if (&ICUD1 == icup) {
      nvicDisableVector(TIM1_CC_IRQn);
      nvicDisableVector(TIM1_UP_IRQn);
      rccDisableTIM1(FALSE);
    }
#endif
#if STM32_ICU_USE_TIM2
    if (&ICUD2 == icup) {
      nvicDisableVector(TIM2_IRQn);
      rccDisableTIM2(FALSE);
    }
#endif
#if STM32_ICU_USE_TIM3
    if (&ICUD3 == icup) {
      nvicDisableVector(TIM3_IRQn);
      rccDisableTIM3(FALSE);
    }
#endif
#if STM32_ICU_USE_TIM4
    if (&ICUD4 == icup) {
      nvicDisableVector(TIM4_IRQn);
      rccDisableTIM4(FALSE);
    }
#endif
#if STM32_ICU_USE_TIM5
    if (&ICUD5 == icup) {
      nvicDisableVector(TIM5_IRQn);
      rccDisableTIM5(FALSE);
    }
#endif
  }
#if STM32_ICU_USE_TIM8
    if (&ICUD8 == icup) {
      nvicDisableVector(TIM8_CC_IRQn);
      nvicDisableVector(TIM8_UP_IRQn);
      rccDisableTIM8(FALSE);
    }
#endif
}

/**
 * @brief   Enables the input capture.
 *
 * @param[in] icup      pointer to the @p ICUDriver object
 *
 * @notapi
 */
void icu_lld_enable(ICUDriver *icup) {

  icup->tim->SR   = 0;                      /* Clear pending IRQs (if any). */
  if (icup->config->ch0_edge_cb != NULL)
    icup->tim->DIER |= TIM_DIER_CC1IE;
  if (icup->config->ch1_edge_cb != NULL)
    icup->tim->DIER |= TIM_DIER_CC2IE;
  if (icup->config->ch2_edge_cb != NULL)
    icup->tim->DIER |= TIM_DIER_CC3IE;
  if (icup->config->ch3_edge_cb != NULL)
    icup->tim->DIER |= TIM_DIER_CC4IE;
  if (icup->config->overflow_cb != NULL)
      icup->tim->DIER |= TIM_DIER_UIE;
  icup->tim->CR1  = TIM_CR1_URS | TIM_CR1_CEN;
}

/**
 * @brief   Disables the input capture.
 *
 * @param[in] icup      pointer to the @p ICUDriver object
 *
 * @notapi
 */
void icu_lld_disable(ICUDriver *icup) {

  icup->tim->CR1  = 0;                      /* Initially stopped.           */
  icup->tim->CR2  = 0;                      /* Reset timer config.          */
  icup->tim->SR   = 0;                      /* Clear pending IRQs (if any). */
  icup->tim->DIER = 0;                      /* Interrupts disabled.         */
}

#endif /* HAL_USE_ICU */

/** @} */
