GHF/gyroking/ChibiOS/os/hal/include/icu.h

/*
    ChibiOS/RT - Copyright (C) 2006,2007,2008,2009,2010,
                 2011,2012 Giovanni Di Sirio.

    This file is part of ChibiOS/RT.

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
                                      ---

    A special exception to the GPL can be applied should you wish to distribute
    a combined work that includes ChibiOS/RT, without being obliged to provide
    the source code for any proprietary components. See the file exception.txt
    for full details of how and when the exception can be applied.
*/

/**
 * @file    icu.h
 * @brief   ICU Driver macros and structures.
 *
 * @addtogroup ICU
 * @{
 */

#ifndef _ICU_H_
#define _ICU_H_

#if HAL_USE_ICU || defined(__DOXYGEN__)

/*===========================================================================*/
/* Driver constants.                                                         */
/*===========================================================================*/

/*===========================================================================*/
/* Driver pre-compile time settings.                                         */
/*===========================================================================*/

/*===========================================================================*/
/* Derived constants and error checks.                                       */
/*===========================================================================*/

/*===========================================================================*/
/* Driver data structures and types.                                         */
/*===========================================================================*/

/**
 * @brief   Driver state machine possible states.
 */
typedef enum {
  ICU_UNINIT = 0,                   /**< Not initialized.                   */
  ICU_STOP = 1,                     /**< Stopped.                           */
  ICU_READY = 2,                    /**< Ready.                             */
  ICU_WAITING = 3,                  /**< Waiting first edge.                */
  ICU_ACTIVE = 4,                   /**< Active cycle phase.                */
  ICU_IDLE = 5,                     /**< Idle cycle phase.                  */
} icustate_t;

/**
 * @brief   Type of a structure representing an ICU driver.
 */
typedef struct ICUDriver ICUDriver;

/**
 * @brief   ICU notification callback type.
 *
 * @param[in] icup      pointer to a @p ICUDriver object
 */
typedef void (*icucallback_t)(ICUDriver *icup);

#include "icu_lld.h"

/*===========================================================================*/
/* Driver macros.                                                            */
/*===========================================================================*/

/**
 * @name    Macro Functions
 * @{
 */
/**
 * @brief   Enables the input capture.
 *
 * @param[in] icup      pointer to the @p ICUDriver object
 *
 * @iclass
 */
#define icuEnableI(icup) icu_lld_enable(icup)

/**
 * @brief   Disables the input capture.
 *
 * @param[in] icup      pointer to the @p ICUDriver object
 *
 * @iclass
 */
#define icuDisableI(icup) icu_lld_disable(icup)

/**
 * @brief   Returns the time of the last edge on channel 0.
 * @details The time is defined as number of ticks since the start of the
 *          input capture.
 *
 * @param[in] icup      pointer to the @p ICUDriver object
 * @return              The number of ticks.
 *
 * @iclass
 */
#define icuGetCh0EdgeI(icup) icu_lld_get_ch0_edge(icup)

/**
 * @brief   Returns the time of the last edge on channel 1.
 * @details The time is defined as number of ticks since the start of the
 *          input capture.
 *
 * @param[in] icup      pointer to the @p ICUDriver object
 * @return              The number of ticks.
 *
 * @iclass
 */
#define icuGetCh1EdgeI(icup) icu_lld_get_ch1_edge(icup)

/**
 * @brief   Returns the time of the last edge on channel 2.
 * @details The time is defined as number of ticks since the start of the
 *          input capture.
 *
 * @param[in] icup      pointer to the @p ICUDriver object
 * @return              The number of ticks.
 *
 * @iclass
 */
#define icuGetCh2EdgeI(icup) icu_lld_get_ch2_edge(icup)

/**
 * @brief   Returns the time of the last edge on channel 3.
 * @details The time is defined as number of ticks since the start of the
 *          input capture.
 *
 * @param[in] icup      pointer to the @p ICUDriver object
 * @return              The number of ticks.
 *
 * @iclass
 */
#define icuGetCh3EdgeI(icup) icu_lld_get_ch3_edge(icup)
/** @} */

/**
 * @name    Low Level driver helper macros
 * @{
 */
/**
 * @brief   Common ISR code, ICU channel 0 edge event.
 *
 * @param[in] icup      pointer to the @p ICUDriver object
 *
 * @notapi
 */
#define _icu_isr_invoke_ch0_edge_cb(icup) {                                    \
  (icup)->state = ICU_ACTIVE;                                                  \
  (icup)->config->ch0_edge_cb(icup);                                           \
}

/**
 * @brief   Common ISR code, ICU channel 1 edge event.
 *
 * @param[in] icup      pointer to the @p ICUDriver object
 *
 * @notapi
 */
#define _icu_isr_invoke_ch1_edge_cb(icup) {                                    \
  (icup)->state = ICU_ACTIVE;                                                  \
  (icup)->config->ch1_edge_cb(icup);                                           \
}

/**
 * @brief   Common ISR code, ICU channel 2 edge event.
 *
 * @param[in] icup      pointer to the @p ICUDriver object
 *
 * @notapi
 */
#define _icu_isr_invoke_ch2_edge_cb(icup) {                                    \
  (icup)->state = ICU_ACTIVE;                                                  \
  (icup)->config->ch2_edge_cb(icup);                                           \
}

/**
 * @brief   Common ISR code, ICU channel 3 edge event.
 *
 * @param[in] icup      pointer to the @p ICUDriver object
 *
 * @notapi
 */
#define _icu_isr_invoke_ch3_edge_cb(icup) {                                    \
  (icup)->state = ICU_ACTIVE;                                                  \
  (icup)->config->ch3_edge_cb(icup);                                           \
}

/**
 * @brief   Common ISR code, ICU timer overflow event.
 *
 * @param[in] icup      pointer to the @p ICUDriver object
 *
 * @notapi
 */
#define _icu_isr_invoke_overflow_cb(icup) {                                 \
  (icup)->config->overflow_cb(icup);                                        \
}
/** @} */

/*===========================================================================*/
/* External declarations.                                                    */
/*===========================================================================*/

#ifdef __cplusplus
extern "C" {
#endif
  void icuInit(void);
  void icuObjectInit(ICUDriver *icup);
  void icuStart(ICUDriver *icup, const ICUConfig *config);
  void icuStop(ICUDriver *icup);
  void icuEnable(ICUDriver *icup);
  void icuDisable(ICUDriver *icup);
#ifdef __cplusplus
}
#endif

#endif /* HAL_USE_ICU */

#endif /* _ICU_H_ */

/** @} */
