GHF/gyroking/(commit log)

2012-10-05 Add board files and blink LEDs project
2012-10-05 Changed directory strcuture, added README & .gitignore
    [cosmic.stp, raisonance.stp]
2012-10-06 Add ADC reading code, turn on FPU
2012-10-10 Add custom edge-triggered ICU driver and gyro_pope command processor; change compile options for snprintf, M_PI, and std math libs
2012-10-10 Moved Tortilla v2.0 board files to top-level directory
2012-10-14 Fix reverse bug, add joystick display, add joystick control; it melts now! Also split Tortilla class into two compilation units.
    [A4960.cpp, Tortilla.h, Tortilla_control.cpp, Tortilla_io.cpp]
2012-12-03 Add PCB design in hardware directory
    [Tortilla.brd, Tortilla.sch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]
2013-03-10 Add the 3D model files
    [1-4_28_boltnut.sldasm, 1-4_28_nut.SLDPRT, 1_4-20_1_5.sldprt, 1_4-28_1_5.sldprt, 4-40_1-2.sldprt, 4-40_3-8.sldprt, 6-32_3-8.sldprt, 6-32_nut.sldprt]
